Digital-MoBa/Arduino-Z21pg-Zentrale/Aufbau Andreas Schreiber/Bauteilliste/Spannungsregler.jpg

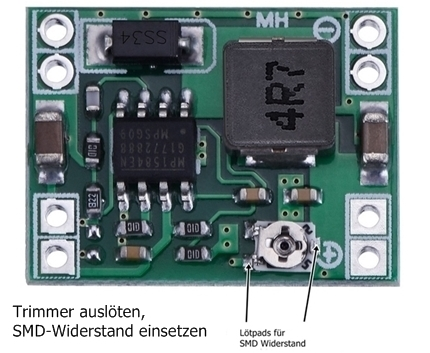
Aufbau Andreas Schreiber/Bauteilliste/Spannungsregler.jpg
