Digital-MoBa/Arduino-Z21pg-Zentrale/Baubericht von Bernd Brendel/Bilder/Hinten.jpg

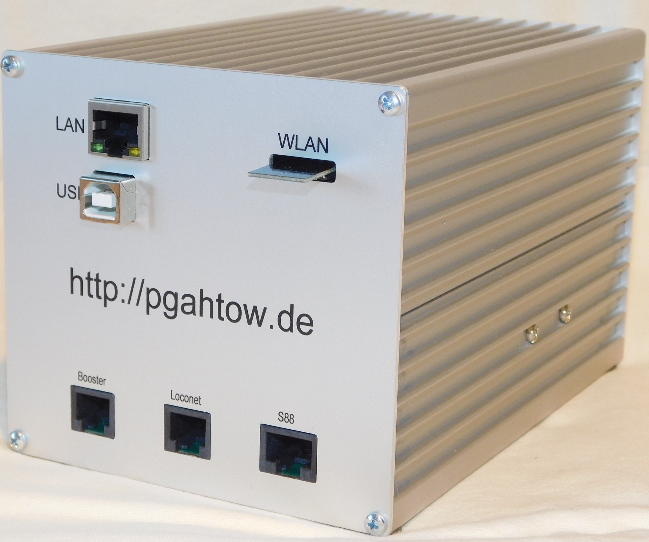
Baubericht von Bernd Brendel/Bilder/Hinten.jpg
