Digital-MoBa/Arduino-Z21pg-Zentrale/Baubericht von Bernd Brendel/Bilder/Innen1.jpg

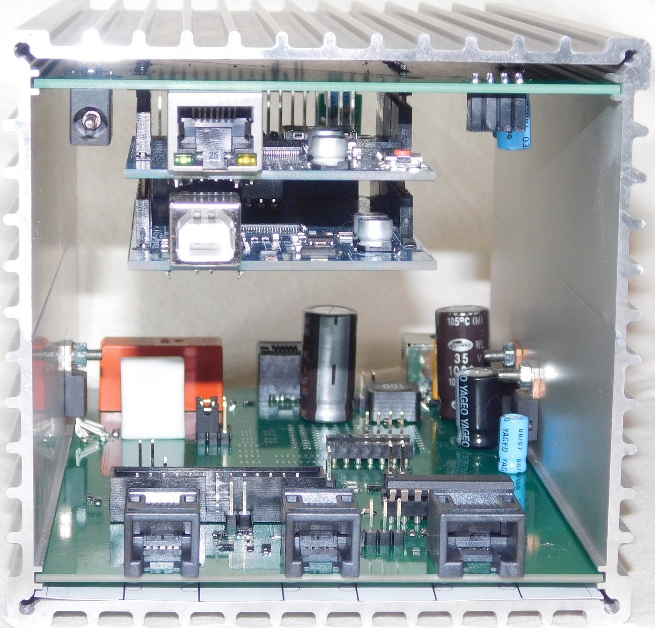
Baubericht von Bernd Brendel/Bilder/Innen1.jpg
