Digital-MoBa/Arduino-Z21pg-Zentrale/Baubericht von Bernd Brendel/Bilder/Vorne.jpg

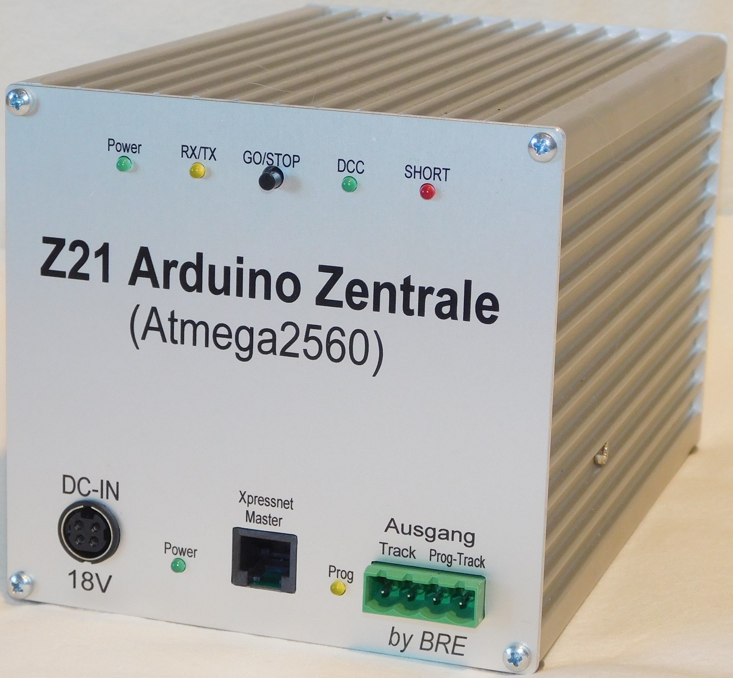
Baubericht von Bernd Brendel/Bilder/Vorne.jpg
