Digital-MoBa/Arduino-Z21pg-Zentrale/Z21pg_DS18B20.jpg

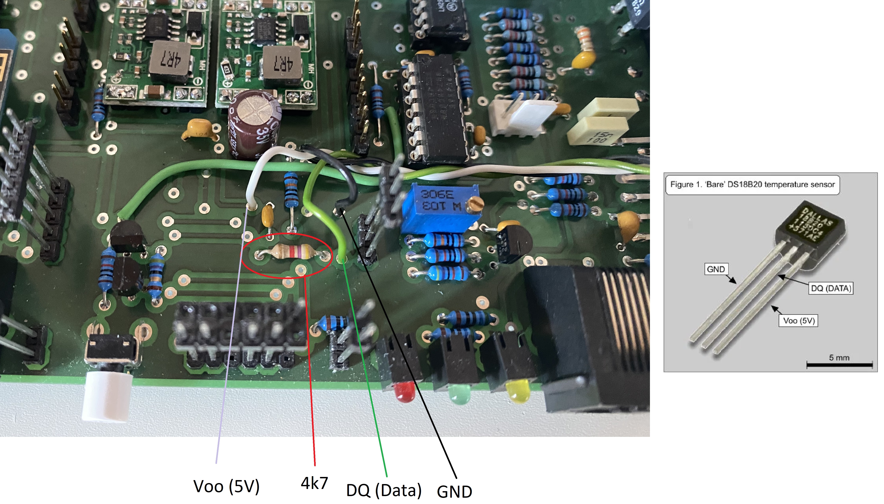
Z21pg_DS18B20.jpg
