Digital-MoBa/Arduino-Z21pg-Zentrale/Aufbau Andreas Schreiber/Bauteilliste/Bauteilliste.xls

Part |  | Reichelt
C1 | 100n | Z5U-5 100N
C2 | 100µF | RAD 100/35
C3 | 100n | Z5U-5 100N
C4 | 100n | Z5U-5 100N
C5 | 1000µF | M-A 1000U 50
C6 | 100n | Z5U-5 100N
C7 | 470n | Z5U-5 470N
C8 | 22n | Z5U-5 22N
C9 | 100n | Z5U-5 100N
C10 | 15nF | MKP2-250 15N
C11 | 15nF | MKP2-250 15N
C12 | 220nF | Z5U-5 220N
C13 | 100nF | Z5U-5 100N
D1 | 1N4004 | 1N 4004
D2 | 1N4148DO35-10 | 1N 4148
D3 | 1N4004 | 1N 4004
DCC_STATUS | LED grün | LED B-3 GN
F1 | PFRA | z.B. PFRA250
IC1 | MAX 485 | MAX 485 CPA
IC3 | LM293 | LM 2903 DIP
IC4 | 74HC244N | SN 74HC244N TEX
IC5 | 74HC08N | SN 74HC08N TEX
IC9 | L6203 | L6203
J1 | Roco Booster | MEBP 6-6S
J2 | S88N | MEBP 8-8S
J3 | LocoNet | MEBP 6-6S
J4 | Xnet | MEBP 6-6S
J8 | Power |  | Holbuchse 5,5/2,1
J9 | Xnet | MEBP 6-6S
JP | 2 Stück | STAPELLEISTE 20
JP | 8 Stück | MPE 087-1-002
JP | 1 Stück | SL 2X17G 2,54
K1 | G2R2 | FIN 40.52.9 12V
OK1 | PC817 | LTV 817
R1 | 2k2 | 1/4W
R2 | 10k | 1/4W
R3 | 10k | 1/4W
R4 | 10k | 1/4W
R5 | 560 | 1/4W
R6 | 560 | 1/4W
R7 | 10k | 1/4W
R8 | 10k | 1/4W
R9 | 10k | 1/4W
R10 | 4,7k | 1/4W
R11 | 0R33/30W | CAD MP930-0.33
R12 | 0R10/30W | CAD MP930-0.10
R13 | 0R10/30W | CAD MP930-0.10
R14 | 100k | 1/4W
R17 | 10k | 1/4W
R20 | 560 | 1/4W
R21 | 100k | 1/4W
R22 | 47k | 1/4W
R23 | 10k | 1/4W
R24 | 4,7k | 1/4W
R25 | 4,7k | 1/4W
R26 | 47 | 1/4W
R27 | 10k | 1/4W 10K
R28 | 47 | 1/4W
R29 | 47 | 1/4W
R30 | 47 | 1/4W
R31 | 47 | 1/4W
R32 | 47 | 1/4W
R33 | 10k | 1/4W
R35 | 15k Temp | NTC-0,2 15K
R36 | 10k | 1/4W
R37 | 120 | 1/4W
R38 | 10k | 1/4W 10K
R39 | 10k | 1/4W
R40 | 1k | 1/4W
R41 | 1k | 1/4W
R42 | 220 | 1/4W
R43 | 220 | 1/4W
R44 | 1M | 1/4W
R45 | 1M | 1/4W
R46 | 220 | 1/4W
R47 | 220 | 1/4W
R48 | 1M | 1/4W
R49 | 1M | 1/4W
R50 | 10k | 1/4W
R51 | 10k | 1/4W
R54 | 3R3 | 1/4W
R55 | 100k | 1/4W
R56 Präzisionspotentiometer | 10k | 64W-10K
S1 |  | TASTER 3305B | (? Kappe)
SEND/RECEIVE | LED gelb | LED B-3 GE
SHORT | LED rot | LED B-3 RT
T1 | BC547 | BC547C
T2 | BC547 | BC547C
T3 | BC547 | BC547C
T4 | BC547 | BC547C
T5 | BC547 | BC547C
T6 | BC547 | BC547C
T8 | BC547 | BC547C
U$2 (Step Down 12V) | MP1584
U$3 (Step Down 5V) | MP1584
X1 1x3-polig - Stecker | 22-23-2031 | MOLEX 26604030 | (für Anschluss Lüfter)
X2 Wannenstecker | PROG | AKL 230-02 & | AKL 249-02
X5 Wannenstecker | Gleis | AKL 230-03 & | AKL 249-03
Kühlkörper | 1 Stück | SK 68/100
5V (Spannungsregler) | 1 Stück | SMD 1/4W 43K
12V (Spannungsregler) | 1 Stück | SMD 1/4W 110K
Distanzhülsen | 4 Stück | DA 8MM
Distanzhülsen | 2 Stück | DA 10MM
Mutter M3 | 2 Stück | (SK-E M3-100)
PC Schrauben | 2 Stück | (ST SCREWM3)
Präzision-Sockelstreifen | 2 Stück | MPE 006-1-002
IC-Sockel, 20-polig | 1 Stück | GS 20P
IC-Sockel, 14-polig | 1 Stück | GS 14P
IC-Sockel, 8-polig | 2 Stück | GS 8P
Glimmerscheibe | 1 Stück | GLIMMER TO 218
Isolierbuchse | 1 Stück | IB 8
Wärmeleitpaste | 1 Stück | NO NT-H1
Schrauben (Kühlkörper L6203 & …) | 2 Stück |  | ? PT- oder TP-Schrauben
(? Lüfter) |  |  | Noctua NF-A4x20 FLX, 12V, 3-Pin
Mega2560 R3 Mikrocontroller | 1 Stück
Ethernet Shield W5100 | 1 Stück
D1 Mini NodeMcu | 1 Stück
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
