Digital-MoBa/Arduino-Z21pg-Zentrale/Aufbau Andreas Schreiber/Bauteilliste/Bestücken.pdf

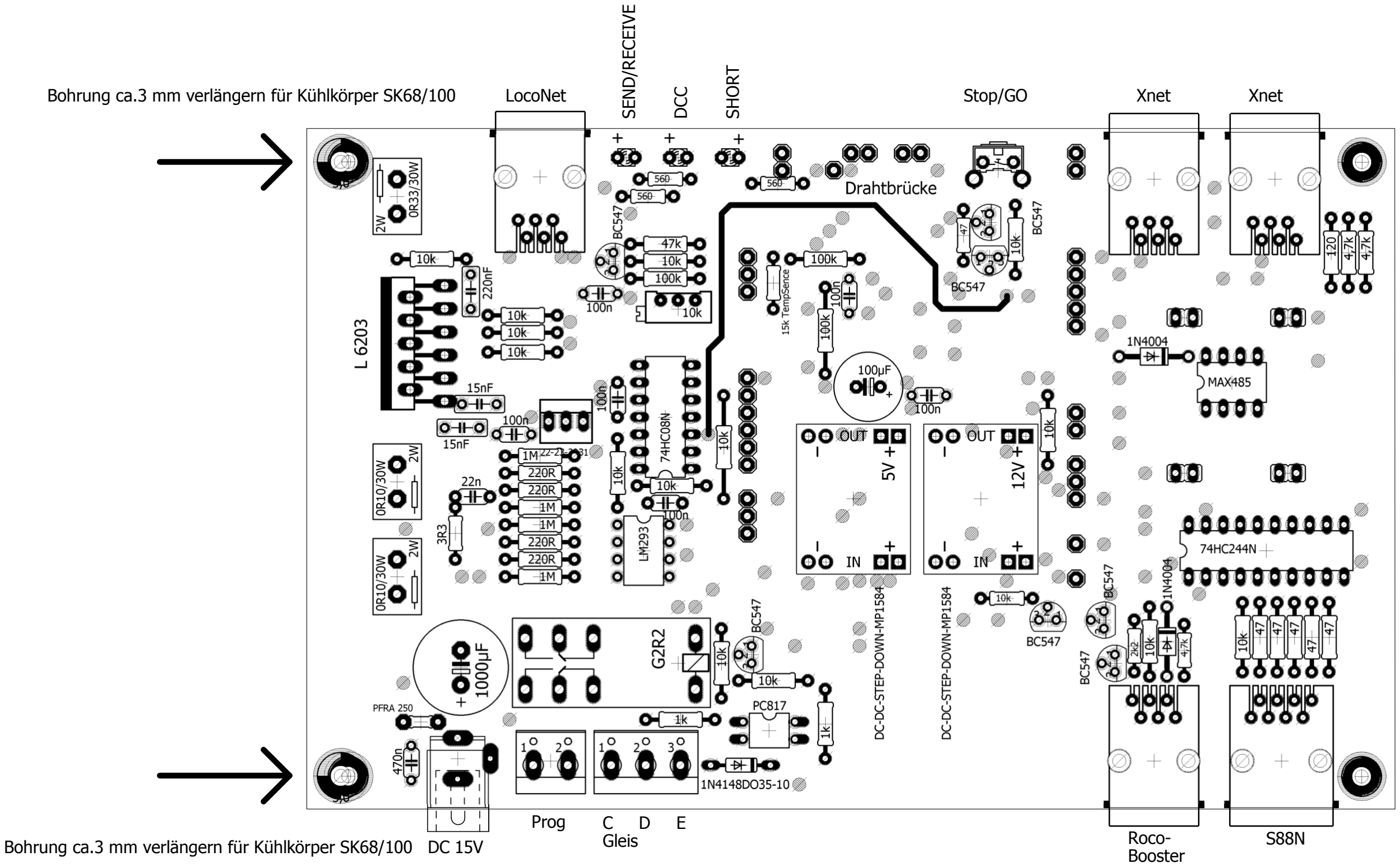
[picture p9: page 1]

+ | +
LocoNet | Xnet | Xnet

Roco-
Booster | S88N DC 15V
Prog | C | D | E
| Gleis

Stop/GO

SEND/RECEIVE

DCC

SHORT Bohrung ca.3 mm verlängern für Kühlkörper SK68/100

Bohrung ca.3 mm verlängern für Kühlkörper SK68/100
