Digital-MoBa/Arduino-Z21pg-Zentrale/Aufbau Andreas Schreiber/Bilder/IMG_1150.JPG

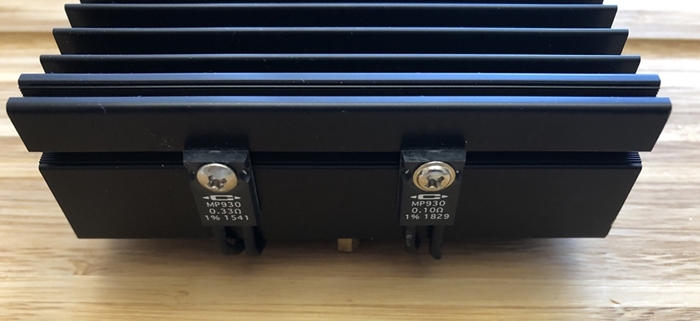
Aufbau Andreas Schreiber/Bilder/IMG_1150.JPG
