Digital-MoBa/Arduino-Z21pg-Zentrale/Aufbau Andreas Schreiber/Bilder/IMG_1151.JPG

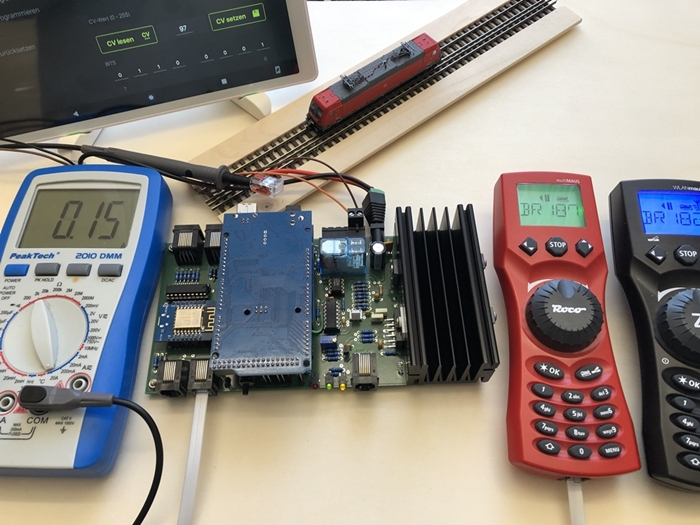
Aufbau Andreas Schreiber/Bilder/IMG_1151.JPG
