Digital-MoBa/Arduino-Z21pg-Zentrale/Aufbau Andreas Schreiber/Gerber.jpg

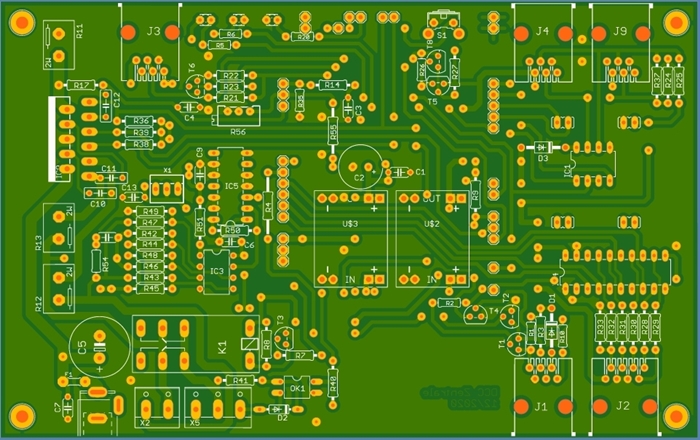
Aufbau Andreas Schreiber/Gerber.jpg
