Digital-MoBa/Arduino-Z21pg-Zentrale/Baubericht von Bernd Brendel/Baubericht.pdf

Hallo liebe Bastelfreunde und Modellbahner,

ich habe mich im Sommer 2020 entschieden, die Z21-Zentrale mit dem ATmega 2560 von Philipp nachzubauen:

http://pgahtow.de/wiki/index.php?title=Z21_Arduino_Zentrale_(Atmega2560)

Bitte habt Verständnis, dass ich keine Garantie geben kann, falls doch noch was nicht richtig funktioniert. Ich habe den Aufbau an meinen Bedarf angepasst.

Die Elektronik habe ich auf zwei Leiterplatten verteilt, welche ich nacheinander bei MME-PCB (http://www.mme-pcb.com/) fertigen ließ. Diese sind günstig, aber haben lange Lieferzeiten, 2 Monate sind keine Seltenheit. Beide Leiterplatten wurden mit Eagle 6.5 entworfen, da ich beruflich Zugang zur Vollversion habe und in meinen Pausen / am Wochenende auch privates machen darf .

Der Hardwarestand von Philipp ist Sommer 2020, der Sketch V4.86 läuft drauf. Der Anschluss eines LocoNet-Boosters ist noch nicht vorhanden (LocoNet-B - Buchse)

Es sollte der Treiber TLE5206-2 verwendet werden.
Der TLE5205-2 hat eine andere Ansteuerung!

Als Gehäuse habe ich ein Euro-Kühlrippengehäuse (Proma 130 048) von Völkner/Conrad gewählt. Dementsprechend sind die Leiterplatten jeweils 165x100mm groß.
Frontplatte und Rückwand habe ich mit Target 3001! (PCB-Pool Edition, kostenlos) erstellt und bei PCB-Pool geordert. Bei den rechteckigen Ausbrüchen müssen noch die Ecken nachgearbeitet werden, da sie gefräst wurden und einen kleinen Radius haben. Das Aluminium hat eine Dicke von 1,5 mm, die Schrift ist aufgedruckt.

Bei den Bauteilen habe ich versucht, meine Vorhandenen zu verwenden, wie z.B. Transistoren und UART-Pegelwandler. Als Transistoren benutze ich Transistoren mit integrierten Widerständen (PDTC143ZT), (https://www.reichelt.de/npn-silicon-digital-transistors-50v-100ma-0-25w-sot-23-pdtc-143zt-nxp-p219246.html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) so genannte Digital-Transistoren oder auch Pre-Biased Transistoren genannt. Das Erspart mir Platz auf meinen Leiterplatten und Lötarbeit. Der Pegelwandler für die UART zum WLAN-Modul ist in jeder Richtung ein 74LVC1T45. Dieser eignet sich sehr gut zum Wandeln von 5V nach 3,3V und umgekehrt. Pin5 bestimmt dabei die Datenrichtung.

Der Arduino mit dem LAN-Shield 'hängt' an der Decke. Die Carrier-LP beinhaltet einen DC/DC-Wandler 12V5V um die Verlustleistung zu reduzieren, einen UART -Pegelwandler zum ESP8266, Status-LEDs, Stop/GO - Taster und einen Stecker für ein Flachbandkabel zur unteren LP.
Am Arduino Mega habe ich die DC-Eingangsbuchse (mittels Heißluft) entfernt: Der kleine Längs-Spannungsregler wird sehr heiß, wenn vom Arduino auch noch das LAN-Shield versorgt wird.
Die Stiftleisten sind zum Teil etwas höher eingelötet, damit alles gerade ist und Kontakt hat.
Seite 1 von 13 | 03/2021

Die untere LP beinhaltet den kompletten Power-Bereich, den Stecker für das Flachbandkabel, sowie alles rund um die Western-Buchsen. Spannungsregler und die Endstufe wurden am Gehäuse festgeschraubt, um Wärme abzuführen. Dabei muß die Endstufe auf jeden Fall isoliert werden. Das Gehäuse liegt am - Pol der Stromversorgung/ auf Masse, also vorsichtig mit anderen Spannungsführenden Teilen der Modellbahn. Bei einem PC mit USB-Verbindung wird das Gehäuse auf Schutzleiter-Potential gezogen durch die Abschirmung.

In den Bildern ist zu sehen, dass ich ein paar 'Angst-Bauteile' vorgesehen habe, um weitere Bauteile für Änderungen bestücken zu können. Diese habe ich für den Bericht entfernt, da die Funktion der Zentrale nun meinen Ansprüchen genügt.

Die Zentrale wird mit 16..20V= versorgt, je nach Spurweite und Bedarf.
Die Ausgangsspannung liegt ca. 1V unter der Eingangsspannung. Es kann z.B. das Netzteil Meanwell GST120A20-R7B (https://www.reichelt.de/tischnetzteil-120-w-20-v-6-a-mw-gst120a20-p171065.html?&trstct=pos_0&nbc=1) (20V/6A) für größere Spurweiten verwendet werden.

Eine ROCO-Lokmaus und ein ROCO-Booster funktionieren, sowie die Ansteuerung über LAN mit der Z21-App. Da am ROCO-Booster 12V rauskommen, habe ich die Verbindung zu den 12V in der Zentrale getrennt, damit keine gegenseitige Speisung erfolgen kann. Das WLAN - Modul funktioniert nach einer kleinen Schaltungskorrektur nun auch.
In dieser Doku ist schon die überarbeitete Variante von Schematic und Board.

Auf Grund fehlender Hardware konnte ich folgendes noch nicht testen:
S88 - Anschluss und LocoNet.
Seite 2 von 13 | 03/2021

Komplettes Gerät:

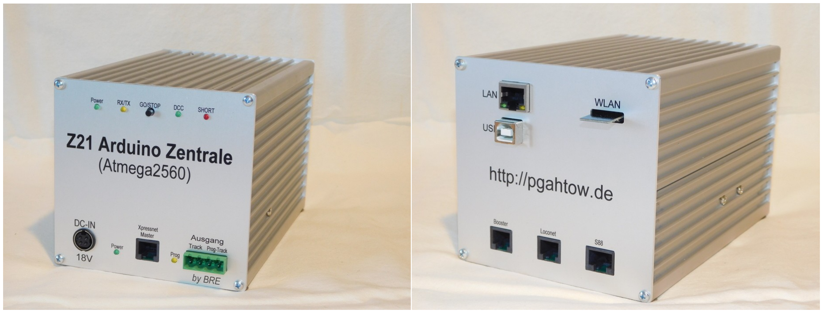
[picture p15: figure]

Das WLAN-Modul ragt heraus.

Seite 3 von 13 | 03/2021

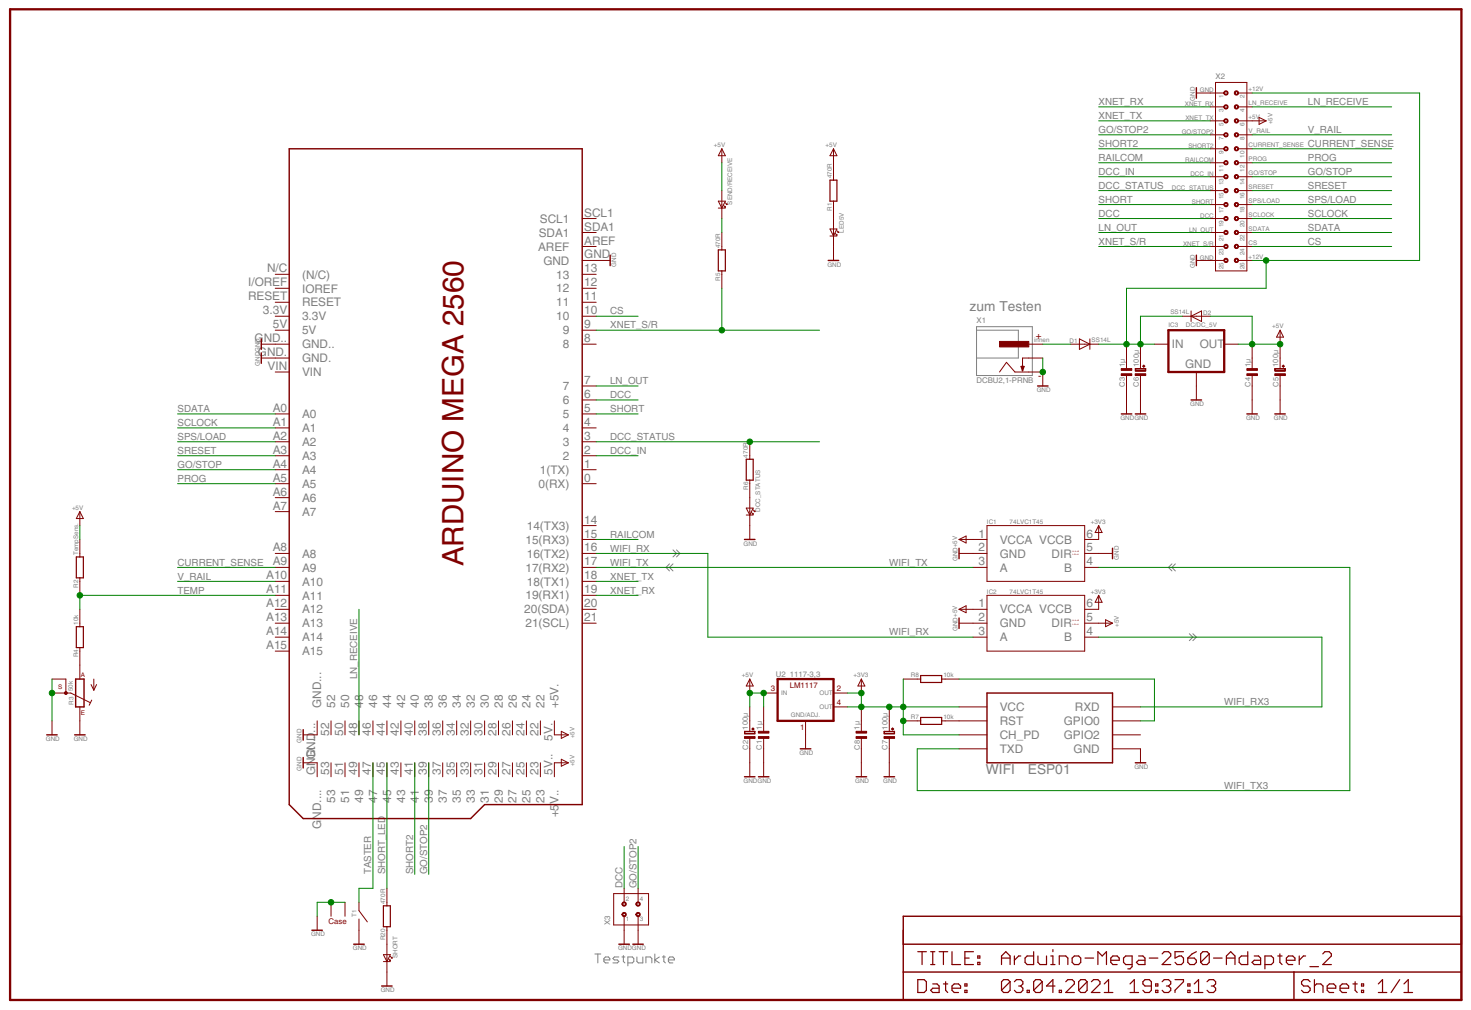
[picture p16: page 4]
zum Testeninnen; GND GND GND GND; GND GND; GND; 1117-3,3 GND; GND 10k 10k 100µ 1µ GND; 74LVC1T45 74LVC1T45 GND GND ⁺⁵V +5V; +3V3 +3V3 +3V3 1µ100µ GNDGND ⁴⁷⁰R; GND GND GND; +5V470R GND; DC/DC_5V GND; +5V 1µ GND; 1µ GND DCBU2,1-PRNB; SS14L GND GNDGND TempSens. 50k GND +5V GND; 100µ GND ¹⁰⁰µ GND GND +5V; 19 20(SDA); 20 21(SCL); AREF; AREF GND; GND GND. GND.; GND.. GND..; GND... GND... GND.... GND.... IOREF I/OREF; RESET RESET; SCL1; SCL1 SDA1; SDA1 VIN VIN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

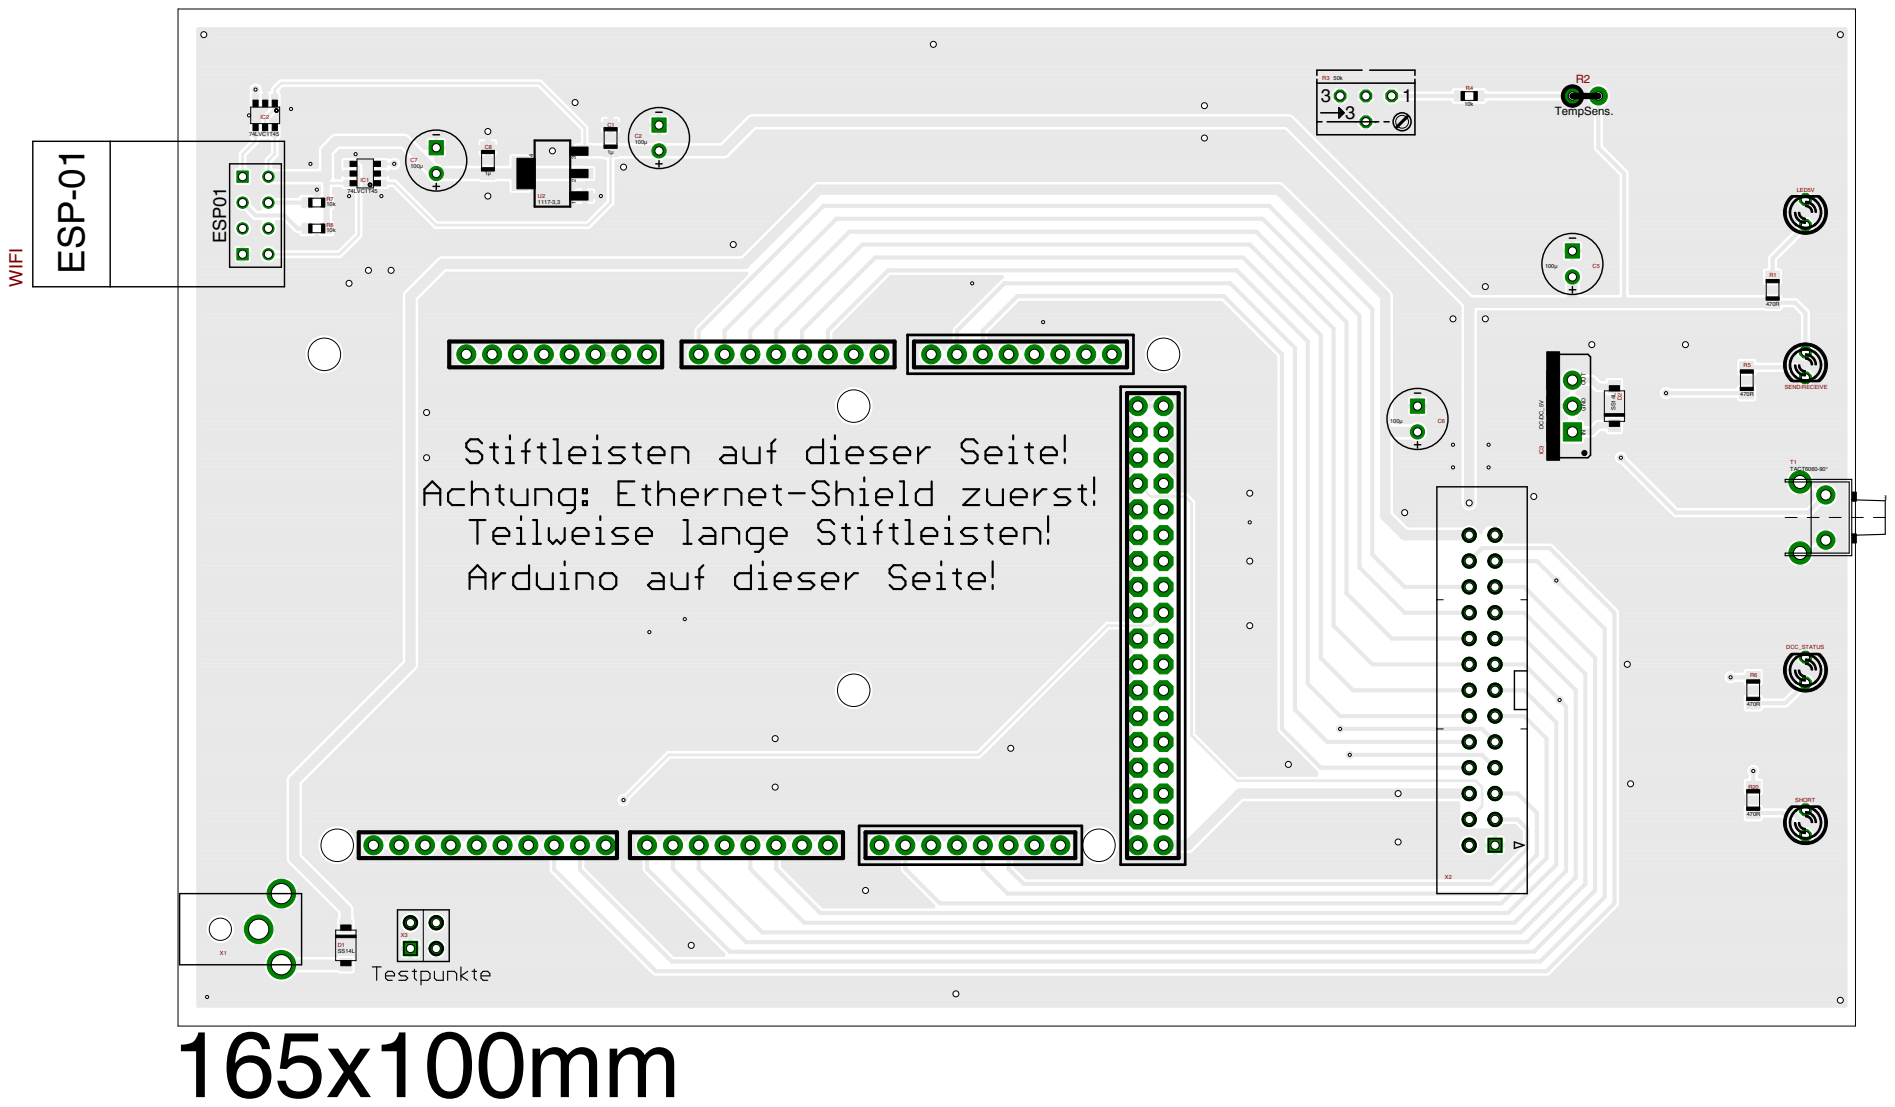
[picture p17: page 5]

43 1 2 ESP-01 GND IN OUT 3 1 165x100mm 3,5mm 3 X2 U2 R7R8 C7 C8 IC1 IC2 C1 C2 WIFI SEND/RECEIVE DCC_STATUS SHORT R5R6 R20 T1 R1 LED5V IC3 X1 D1 X3 R2 R3 R4 C5 C6 D2 1117-3,3 10k 10k 100µ 1µ 74LVC1T45 74LVC1T45 1µ 100µ ESP01 470R470R 470R TACT6060-90° 470R DC/DC_5V SS14L TempSens. 50k 10k 100µ 100µ SS14L

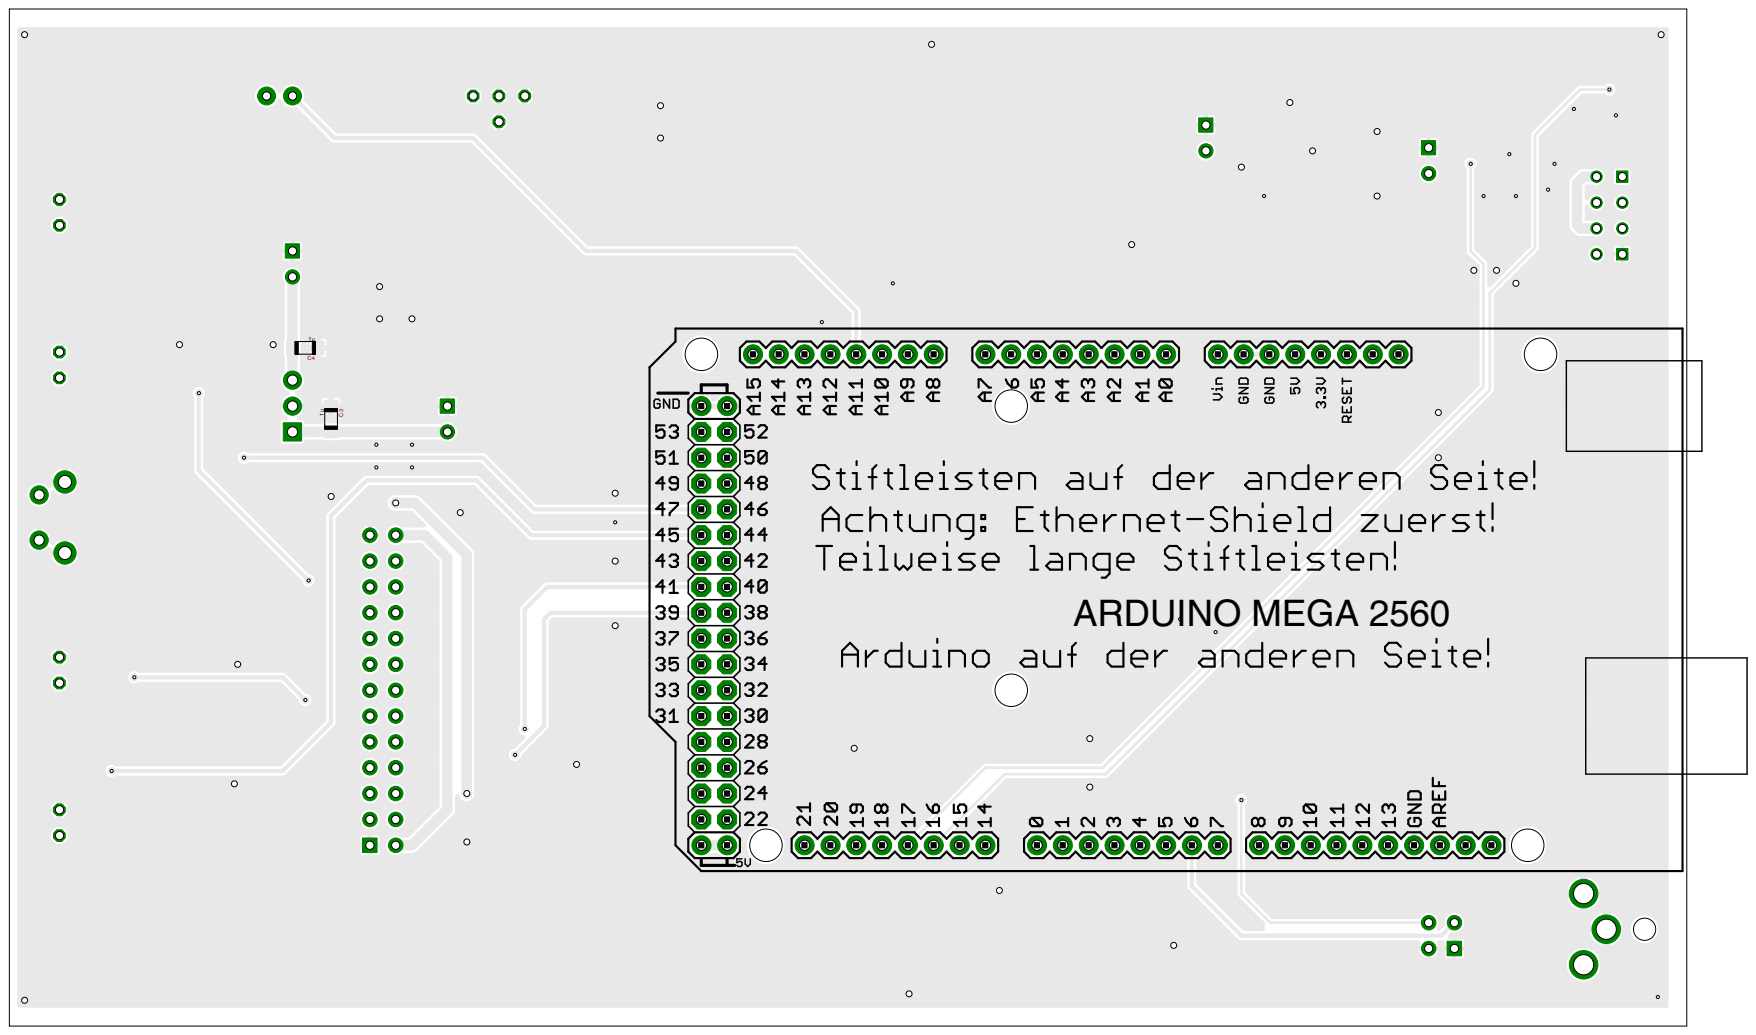
[picture p18: page 6]
ARDUINO MEGA 2560

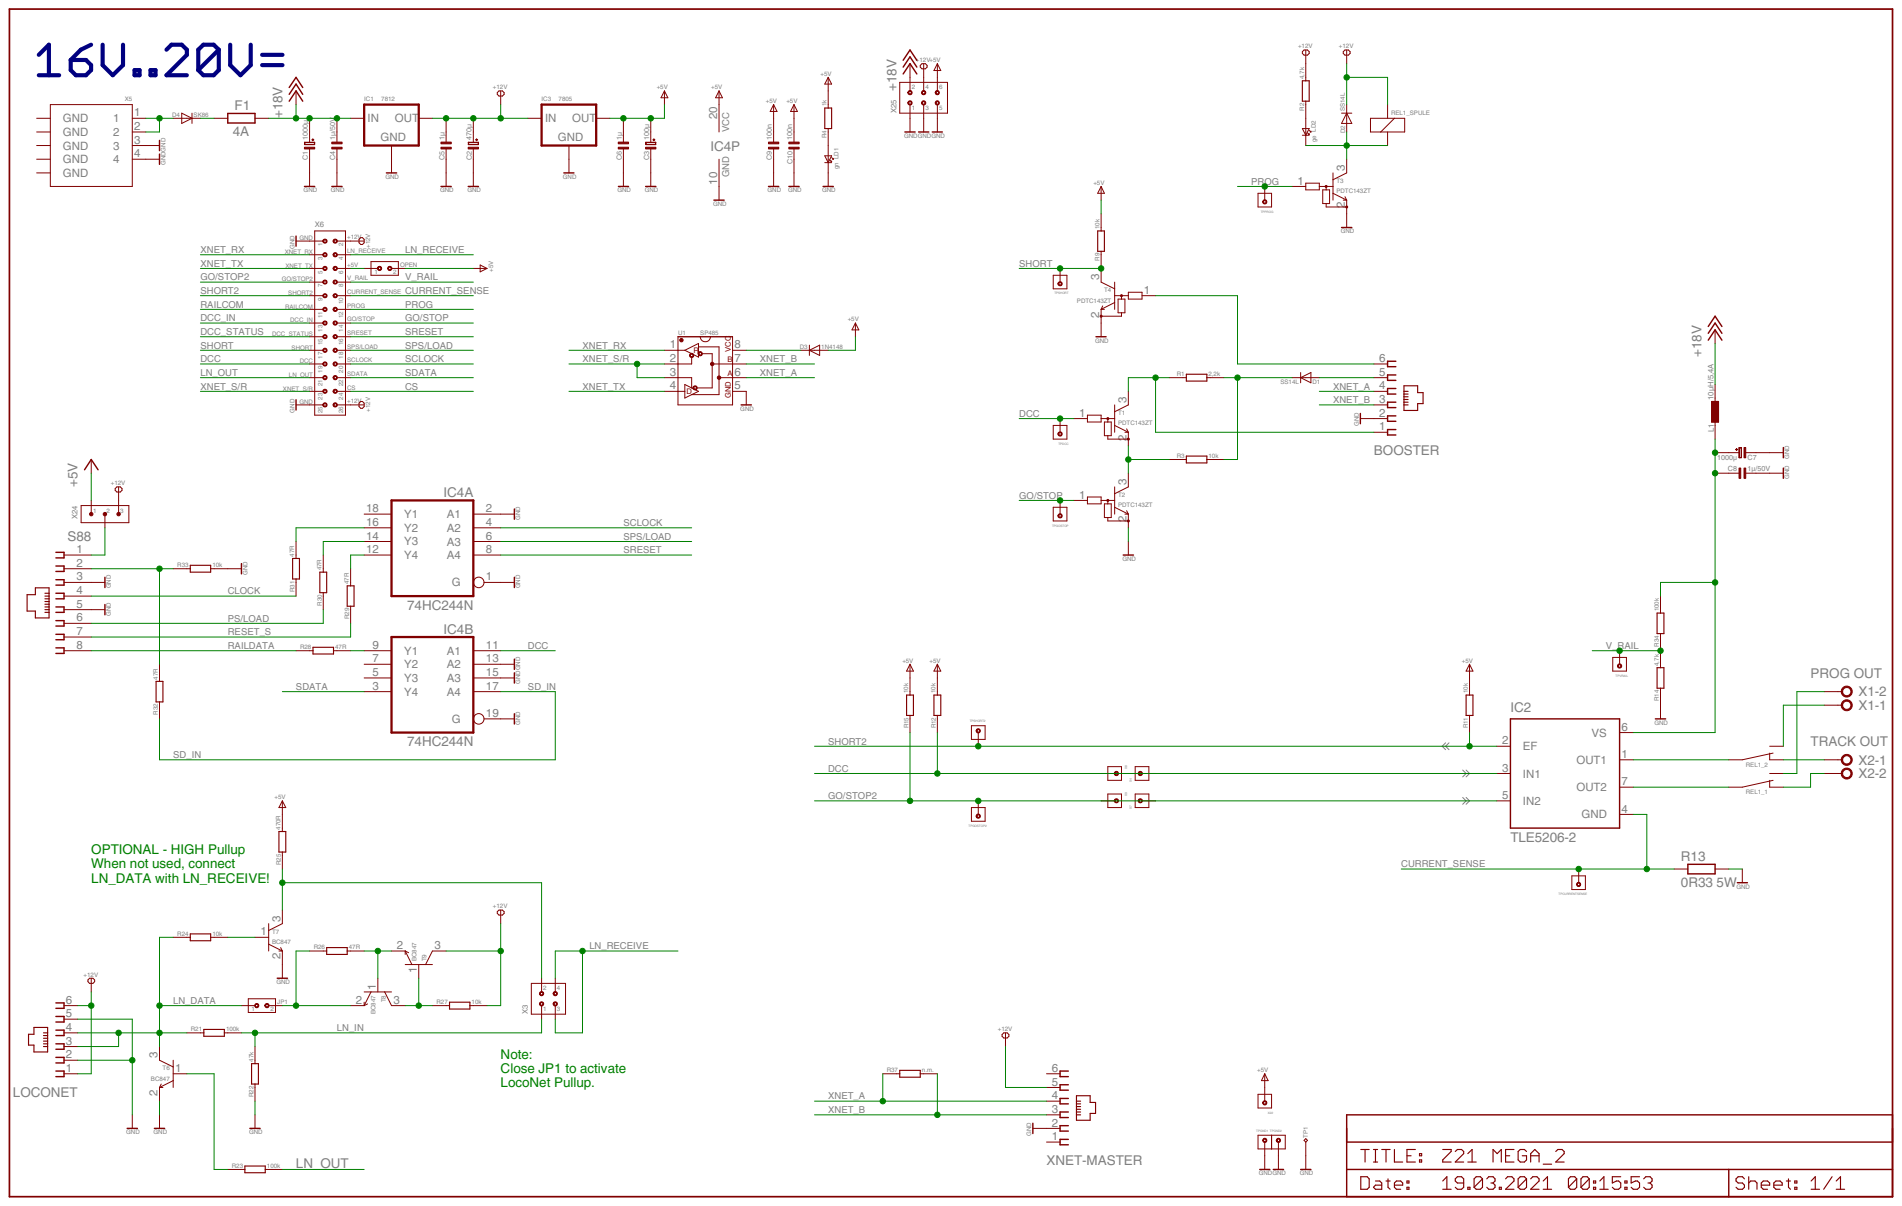
[picture p19: page 7]

4 GND GND GND GND GND

SPS/LOAD GO/STOP

OPTIONAL - HIGH Pullup When not used, connect LN_DATA with LN_RECEIVE!

Note: Close JP1 to activate

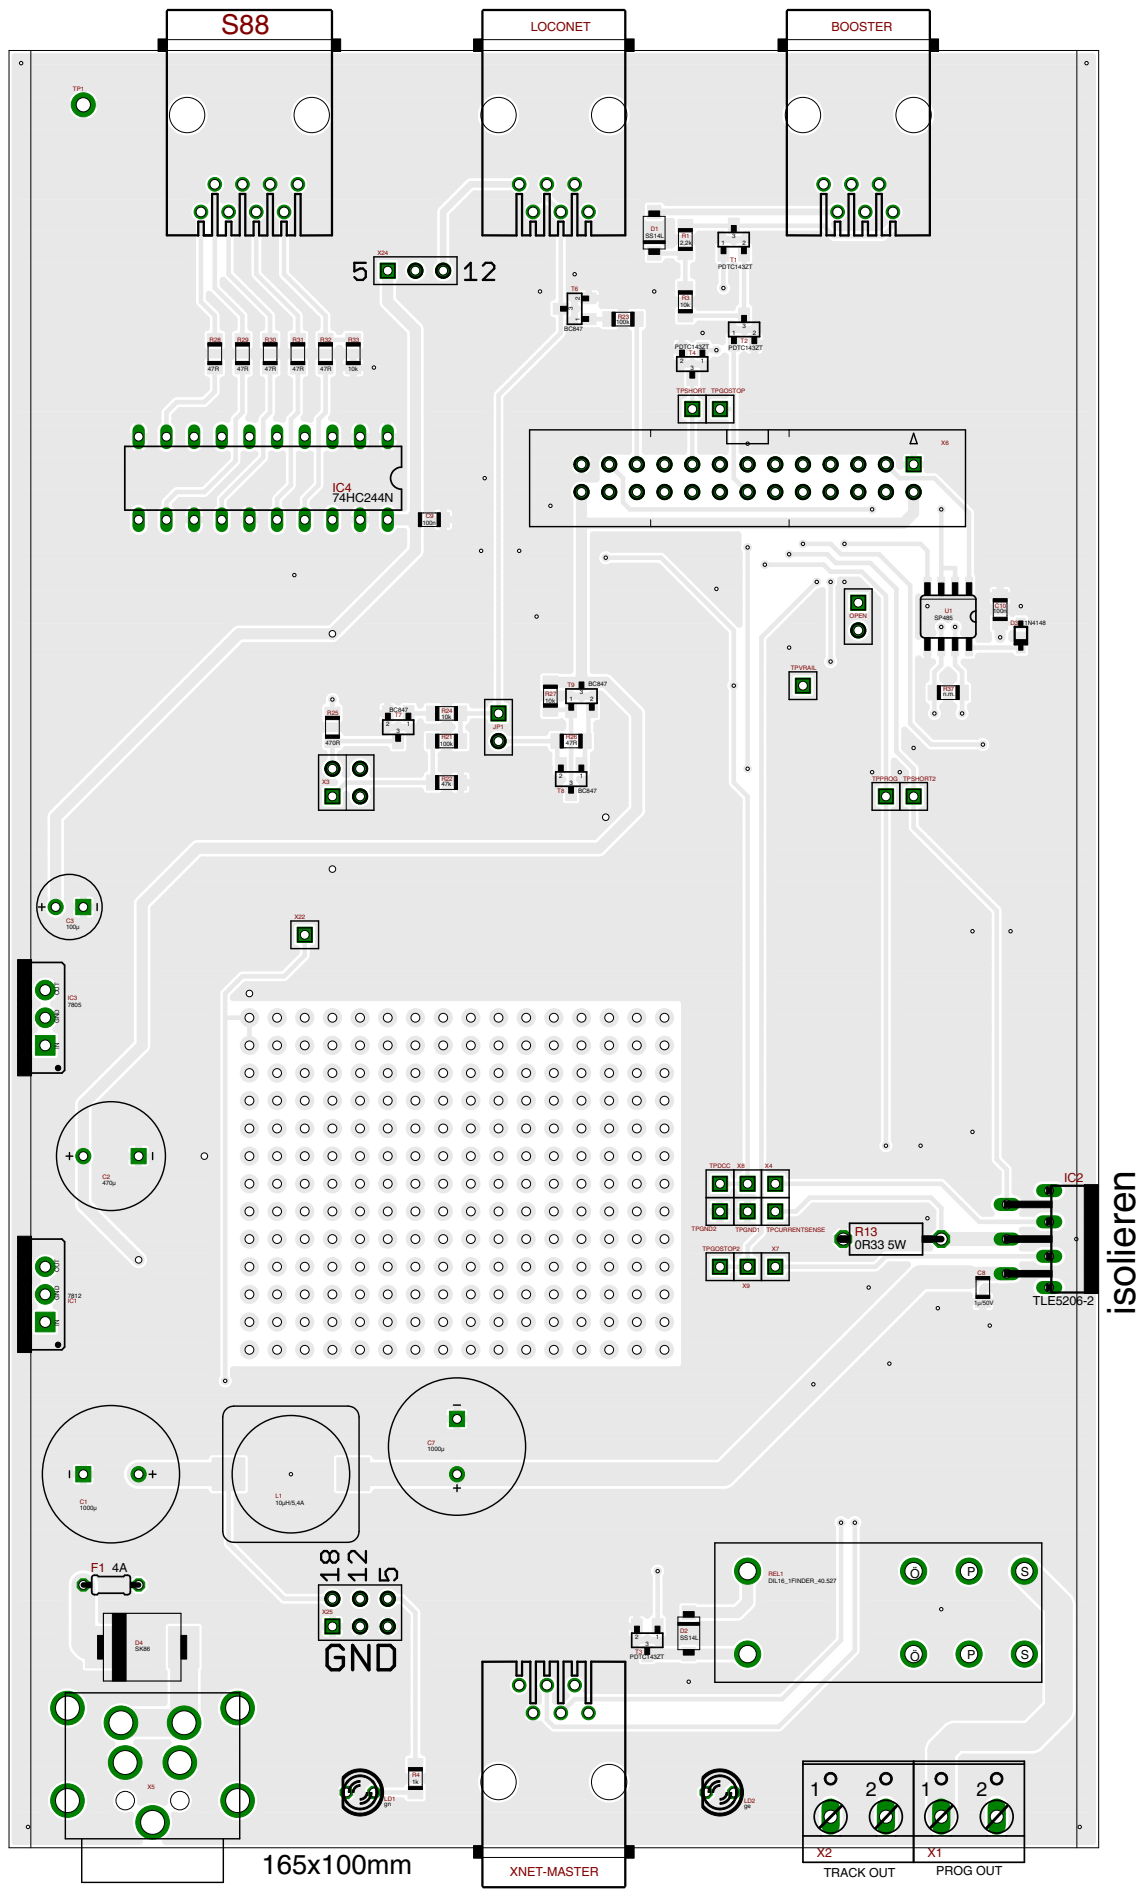
[picture p20: page 8]

GND IN OUT

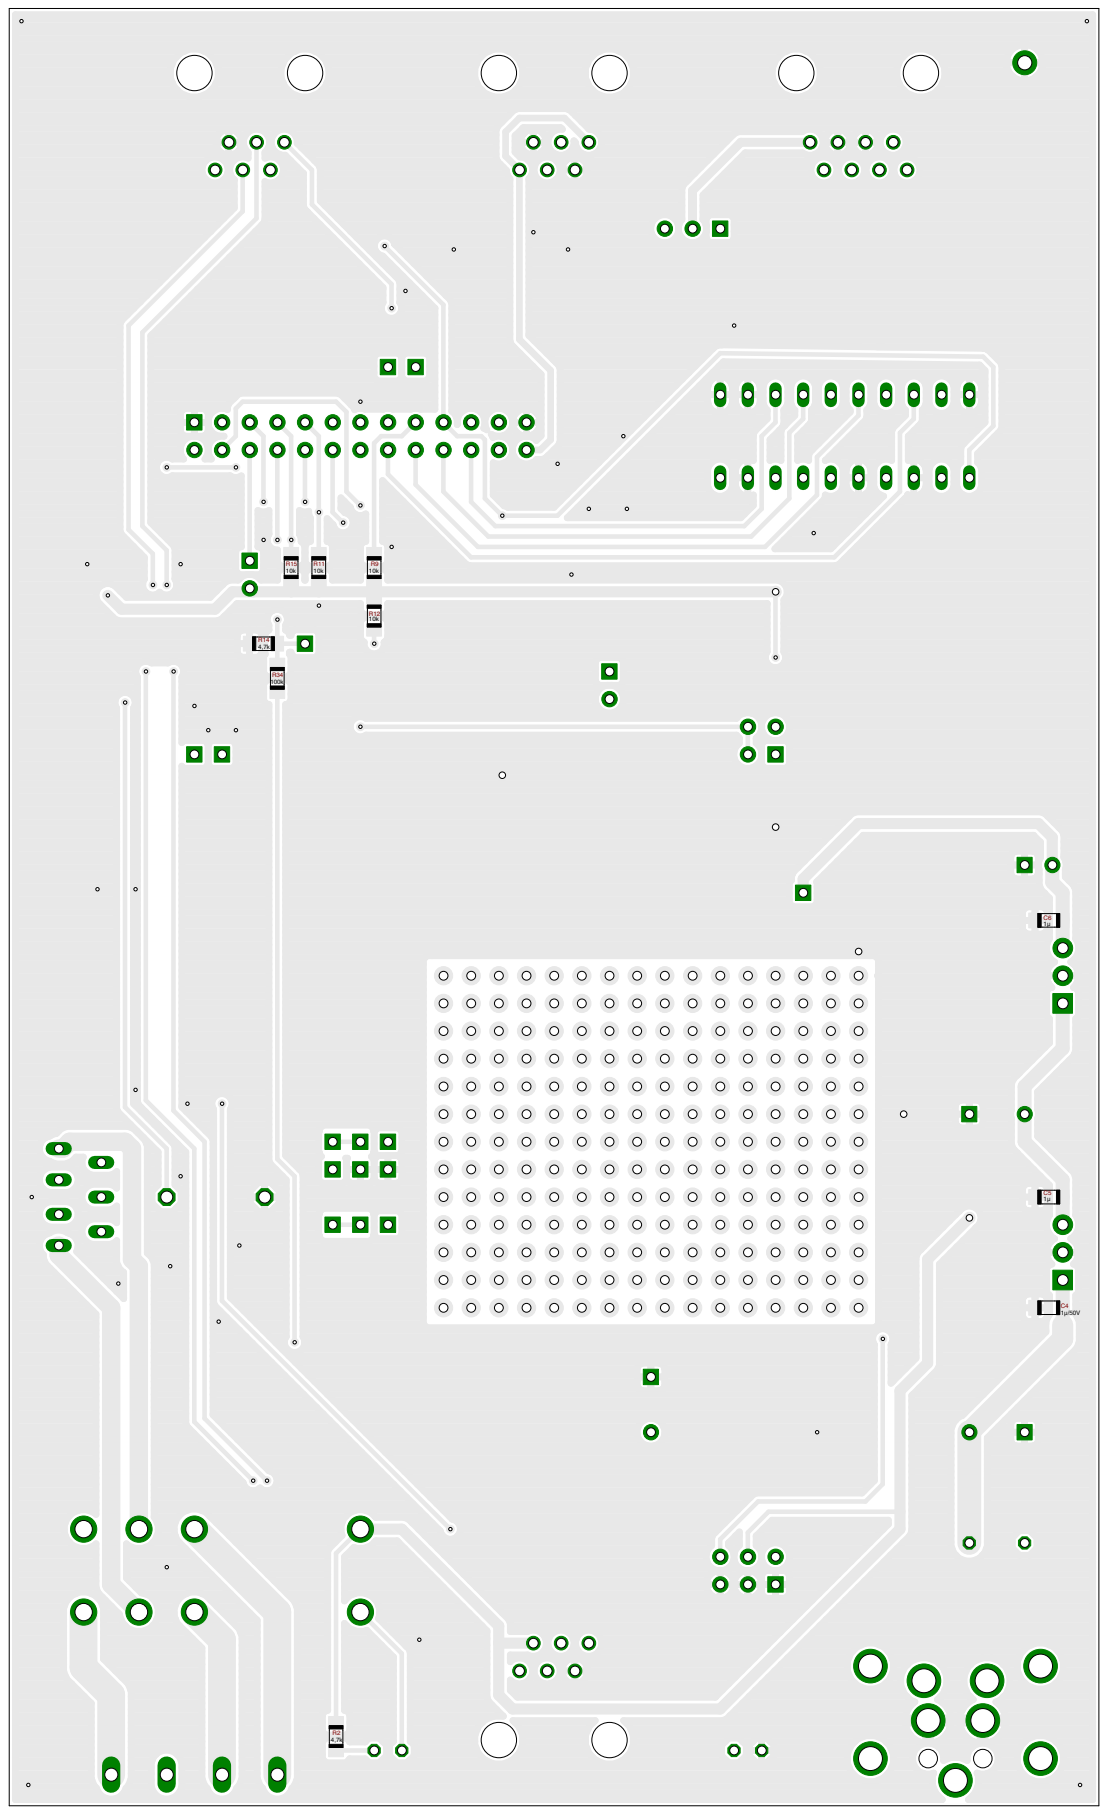
[picture p21: page 9]

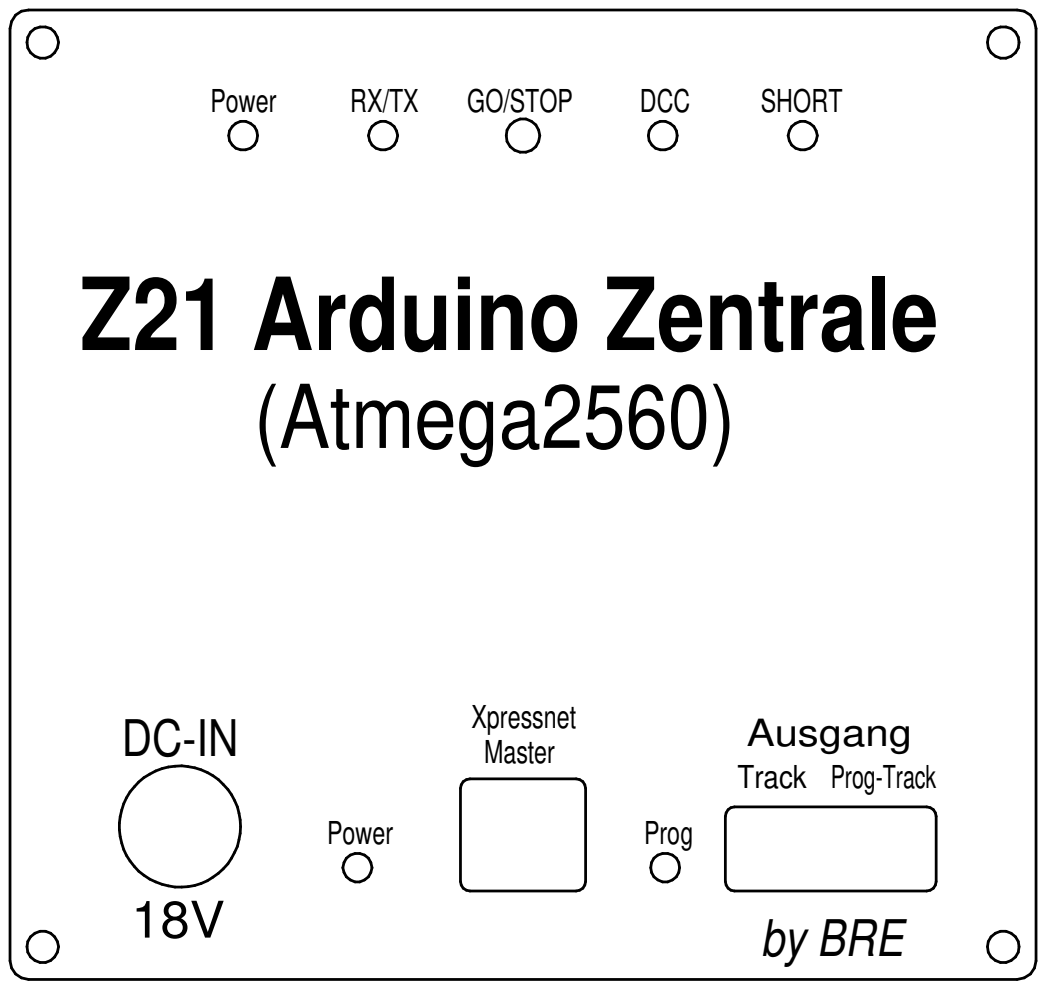
[picture p22: page 10]
Z21 Arduino Zentrale (Atmega2560); Power; GO/STOP; DCC; SHORT; Prog; Master; Prog-Track; Track; Xpressnet; Ausgang; by BRE

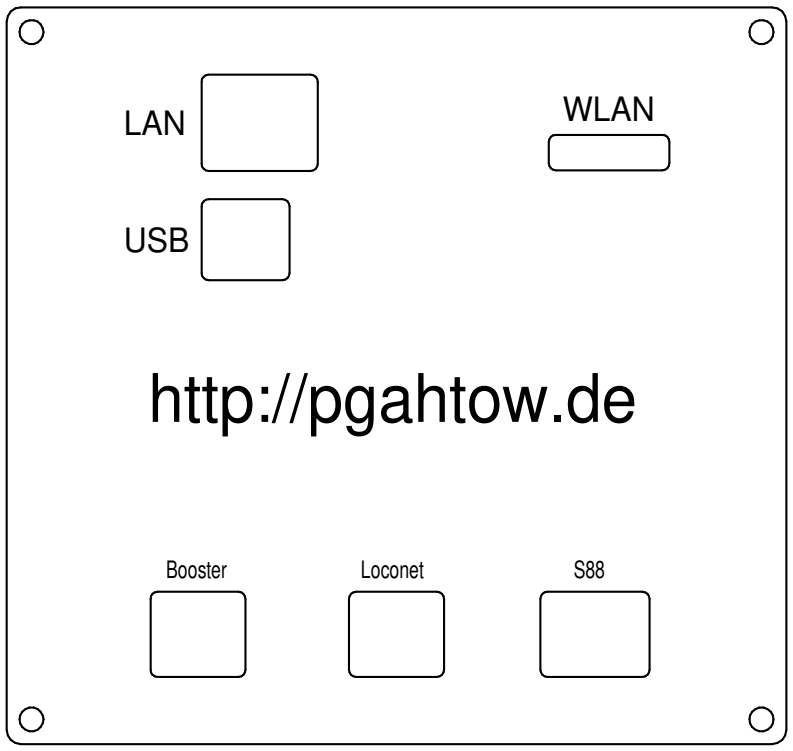
[picture p23: figure]
http://pgahtow.de; WLAN; USB; LAN; Booster; Loconet
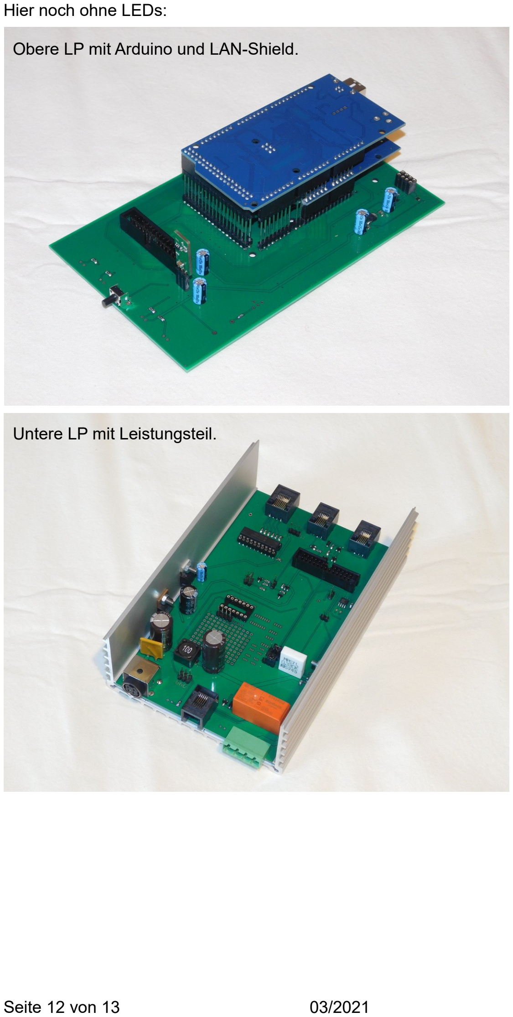
[picture p24: page 12]

Hier noch ohne LEDs:

Obere LP mit Arduino und LAN-Shield.

Untere LP mit Leistungsteil.

Seite 12 von 13 | 03/2021

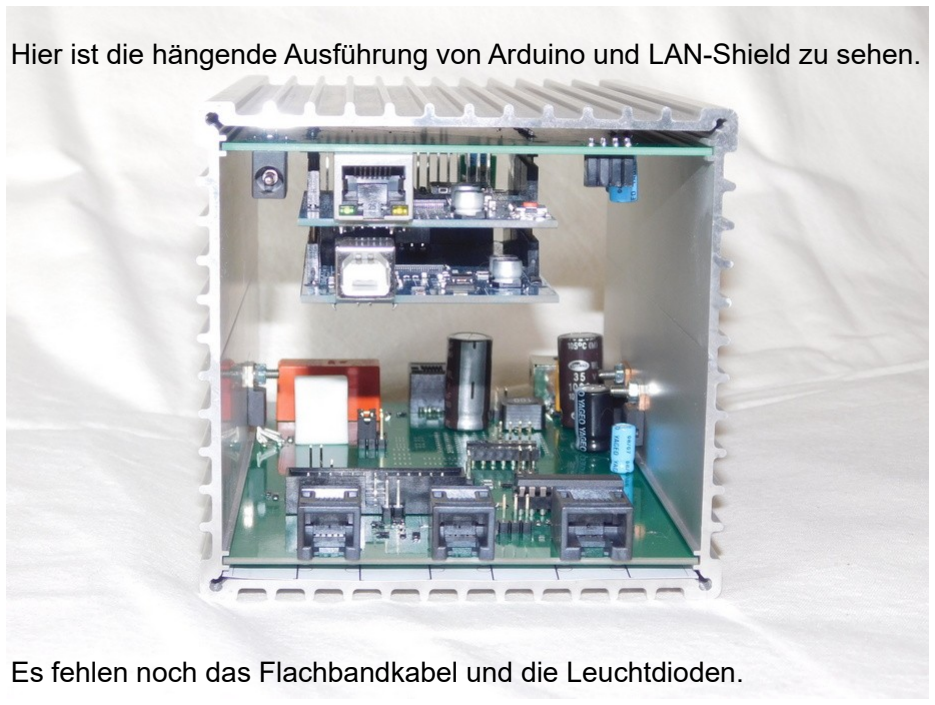
[picture p25: figure]

Hier ist die hängende Ausführung von Arduino und LAN-Shield zu sehen.

Es fehlen noch das Flachbandkabel und die Leuchtdioden.

Bei den bedrahteten Bauteilen ist darauf zu achten, dass die Beine kurz abgeschnitten werden, damit kein Kontakt zum Gehäuse entsteht. Gegebenfalls das Gehäuse mit Klebeband isolieren oder ein dickes Stück Papier bzw. dünne Pappe zwischen Gehäuse und Leiterplatte.

Meine Bezugsquellen für Bauteile:
- Völkner (http://www.voelkner.de/) / Conrad (http://www.conrad.de/)
- Reichelt (http://www.reichelt.de/)
- Segor (http://www.segor.de/) in Berlin, auch Versand
- Mouser (http://www.mouser.de/)

Bei Fehlern und Anregungen könnt Ihr mich kontaktieren.

Nochmal vielen Dank an Philipp für die Idee und Entwicklung der Zentrale.

Grüße aus Berlin
Bernd ( b.brendel@gmx.de )
Seite 13 von 13 | 03/2021
