Digital-MoBa/Arduino-Z21pg-Zentrale/Aufbau Andreas Schreiber/Bauteilliste/Schaltplan.pdf

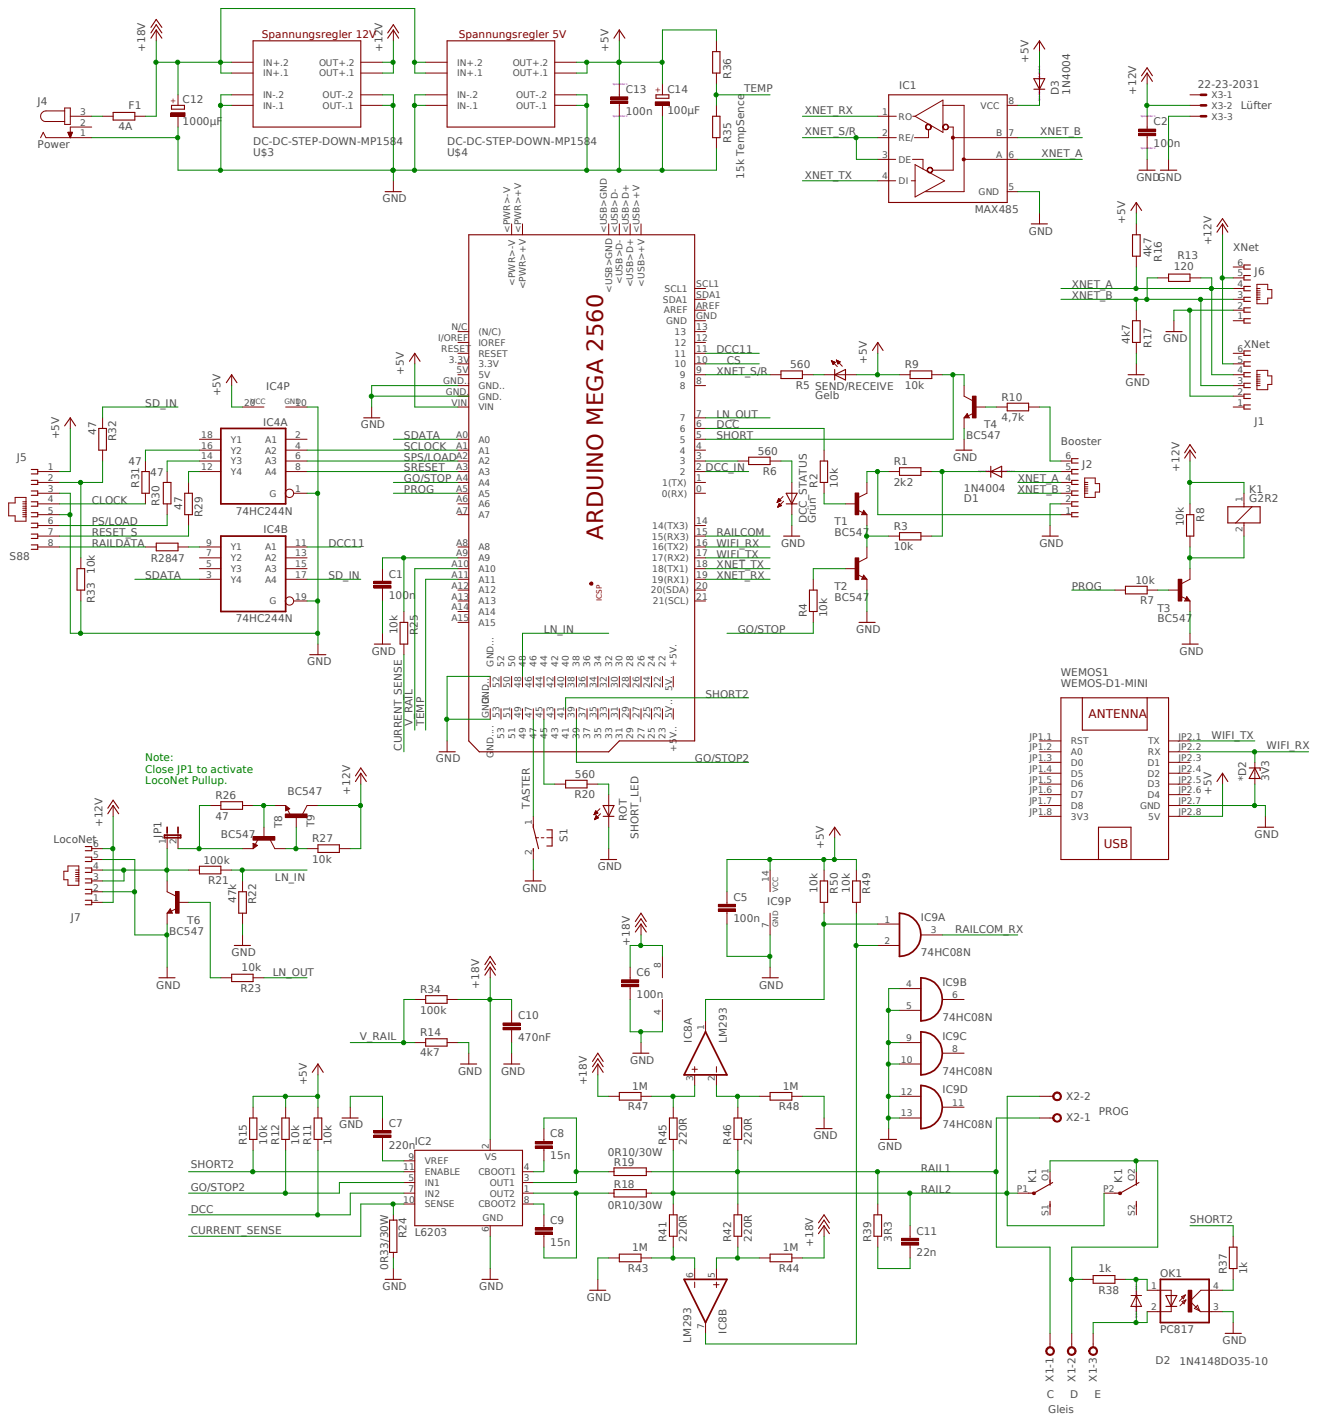
[picture p26: page 1]

GND. | 7
VIN

10 | 8
