Digital-MoBa/Arduino-Z21pg-Zentrale/Aufbau Andreas Schreiber/Bauteilliste/Schaltpl_Platine.pdf

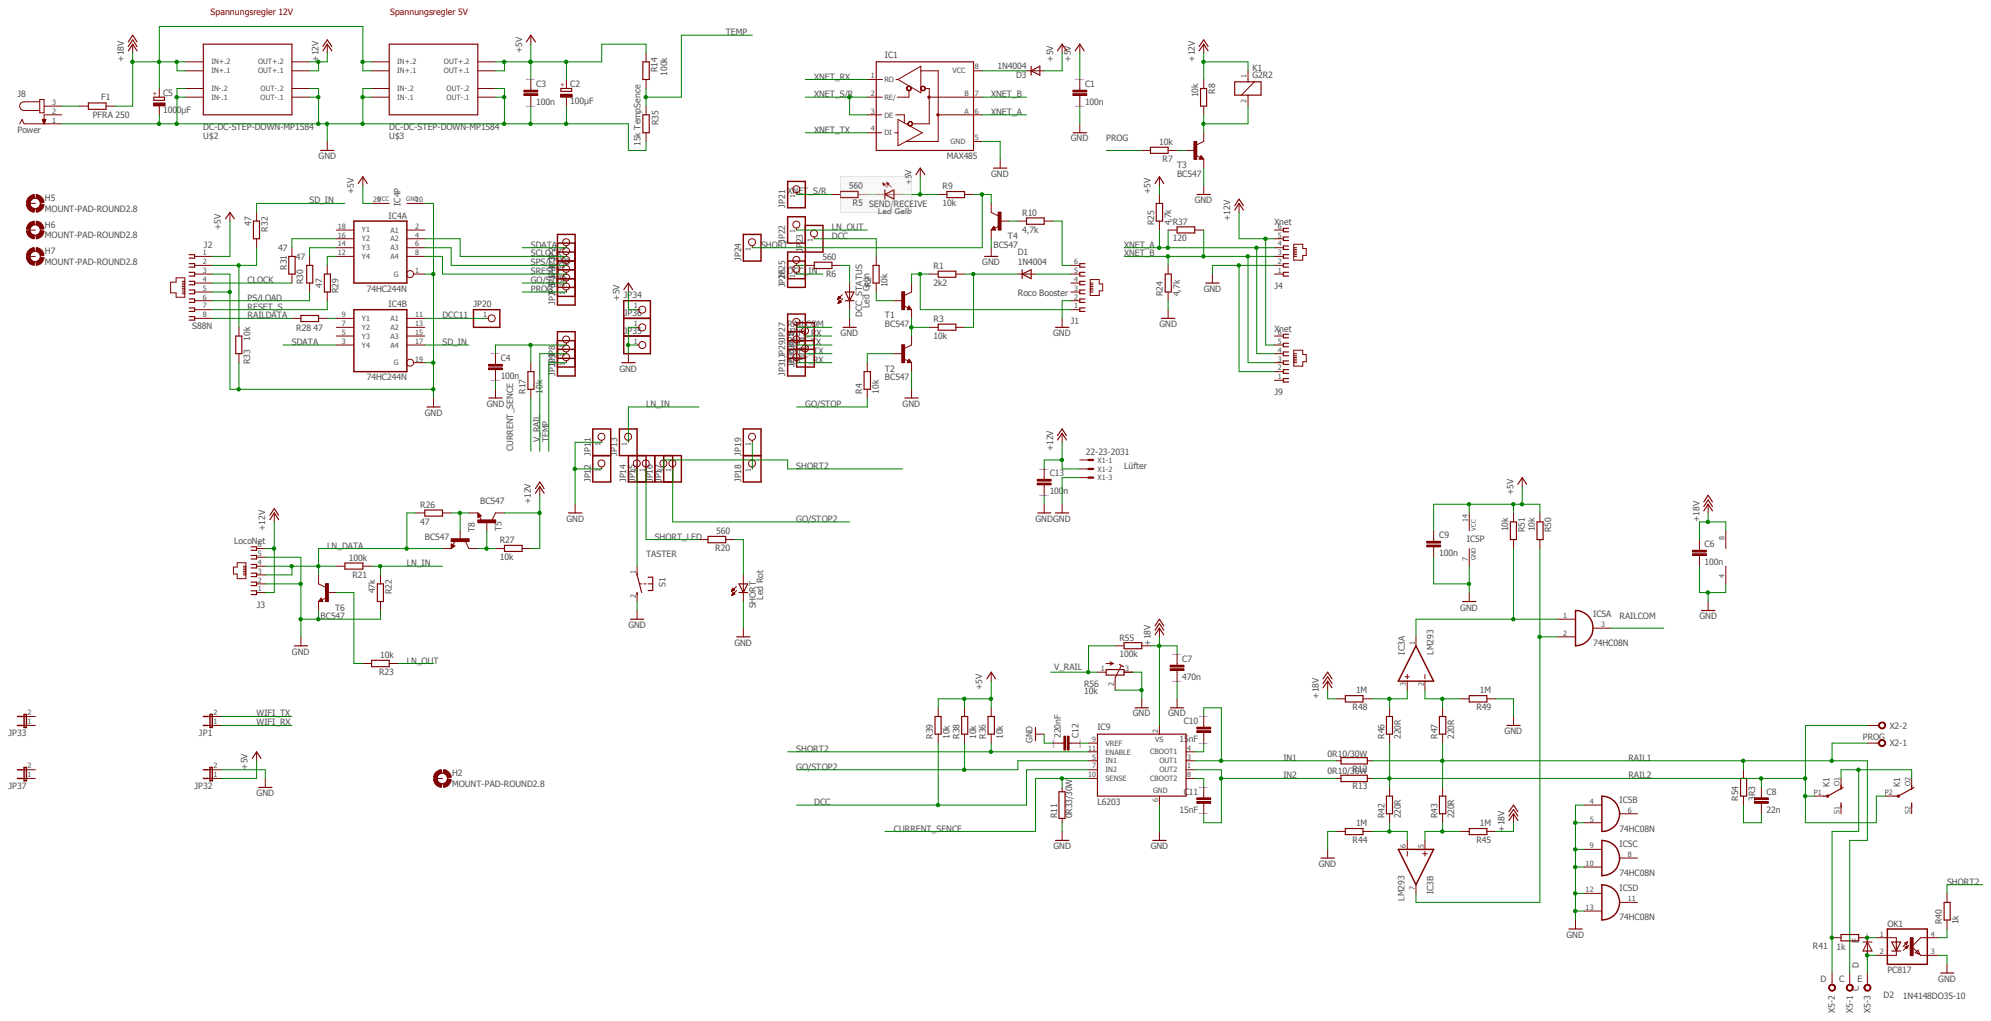
[picture p27: page 1]
