Digital-MoBa/Arduino-Z21pg-Zentrale/Baubericht von Bernd Brendel/Eagle6/Arduino-Mega-2560-Adapter_2.brd

## EAGLE design Baubericht von Bernd Brendel/Eagle6/Arduino-Mega-2560-Adapter_2.brd (2021-04-14)

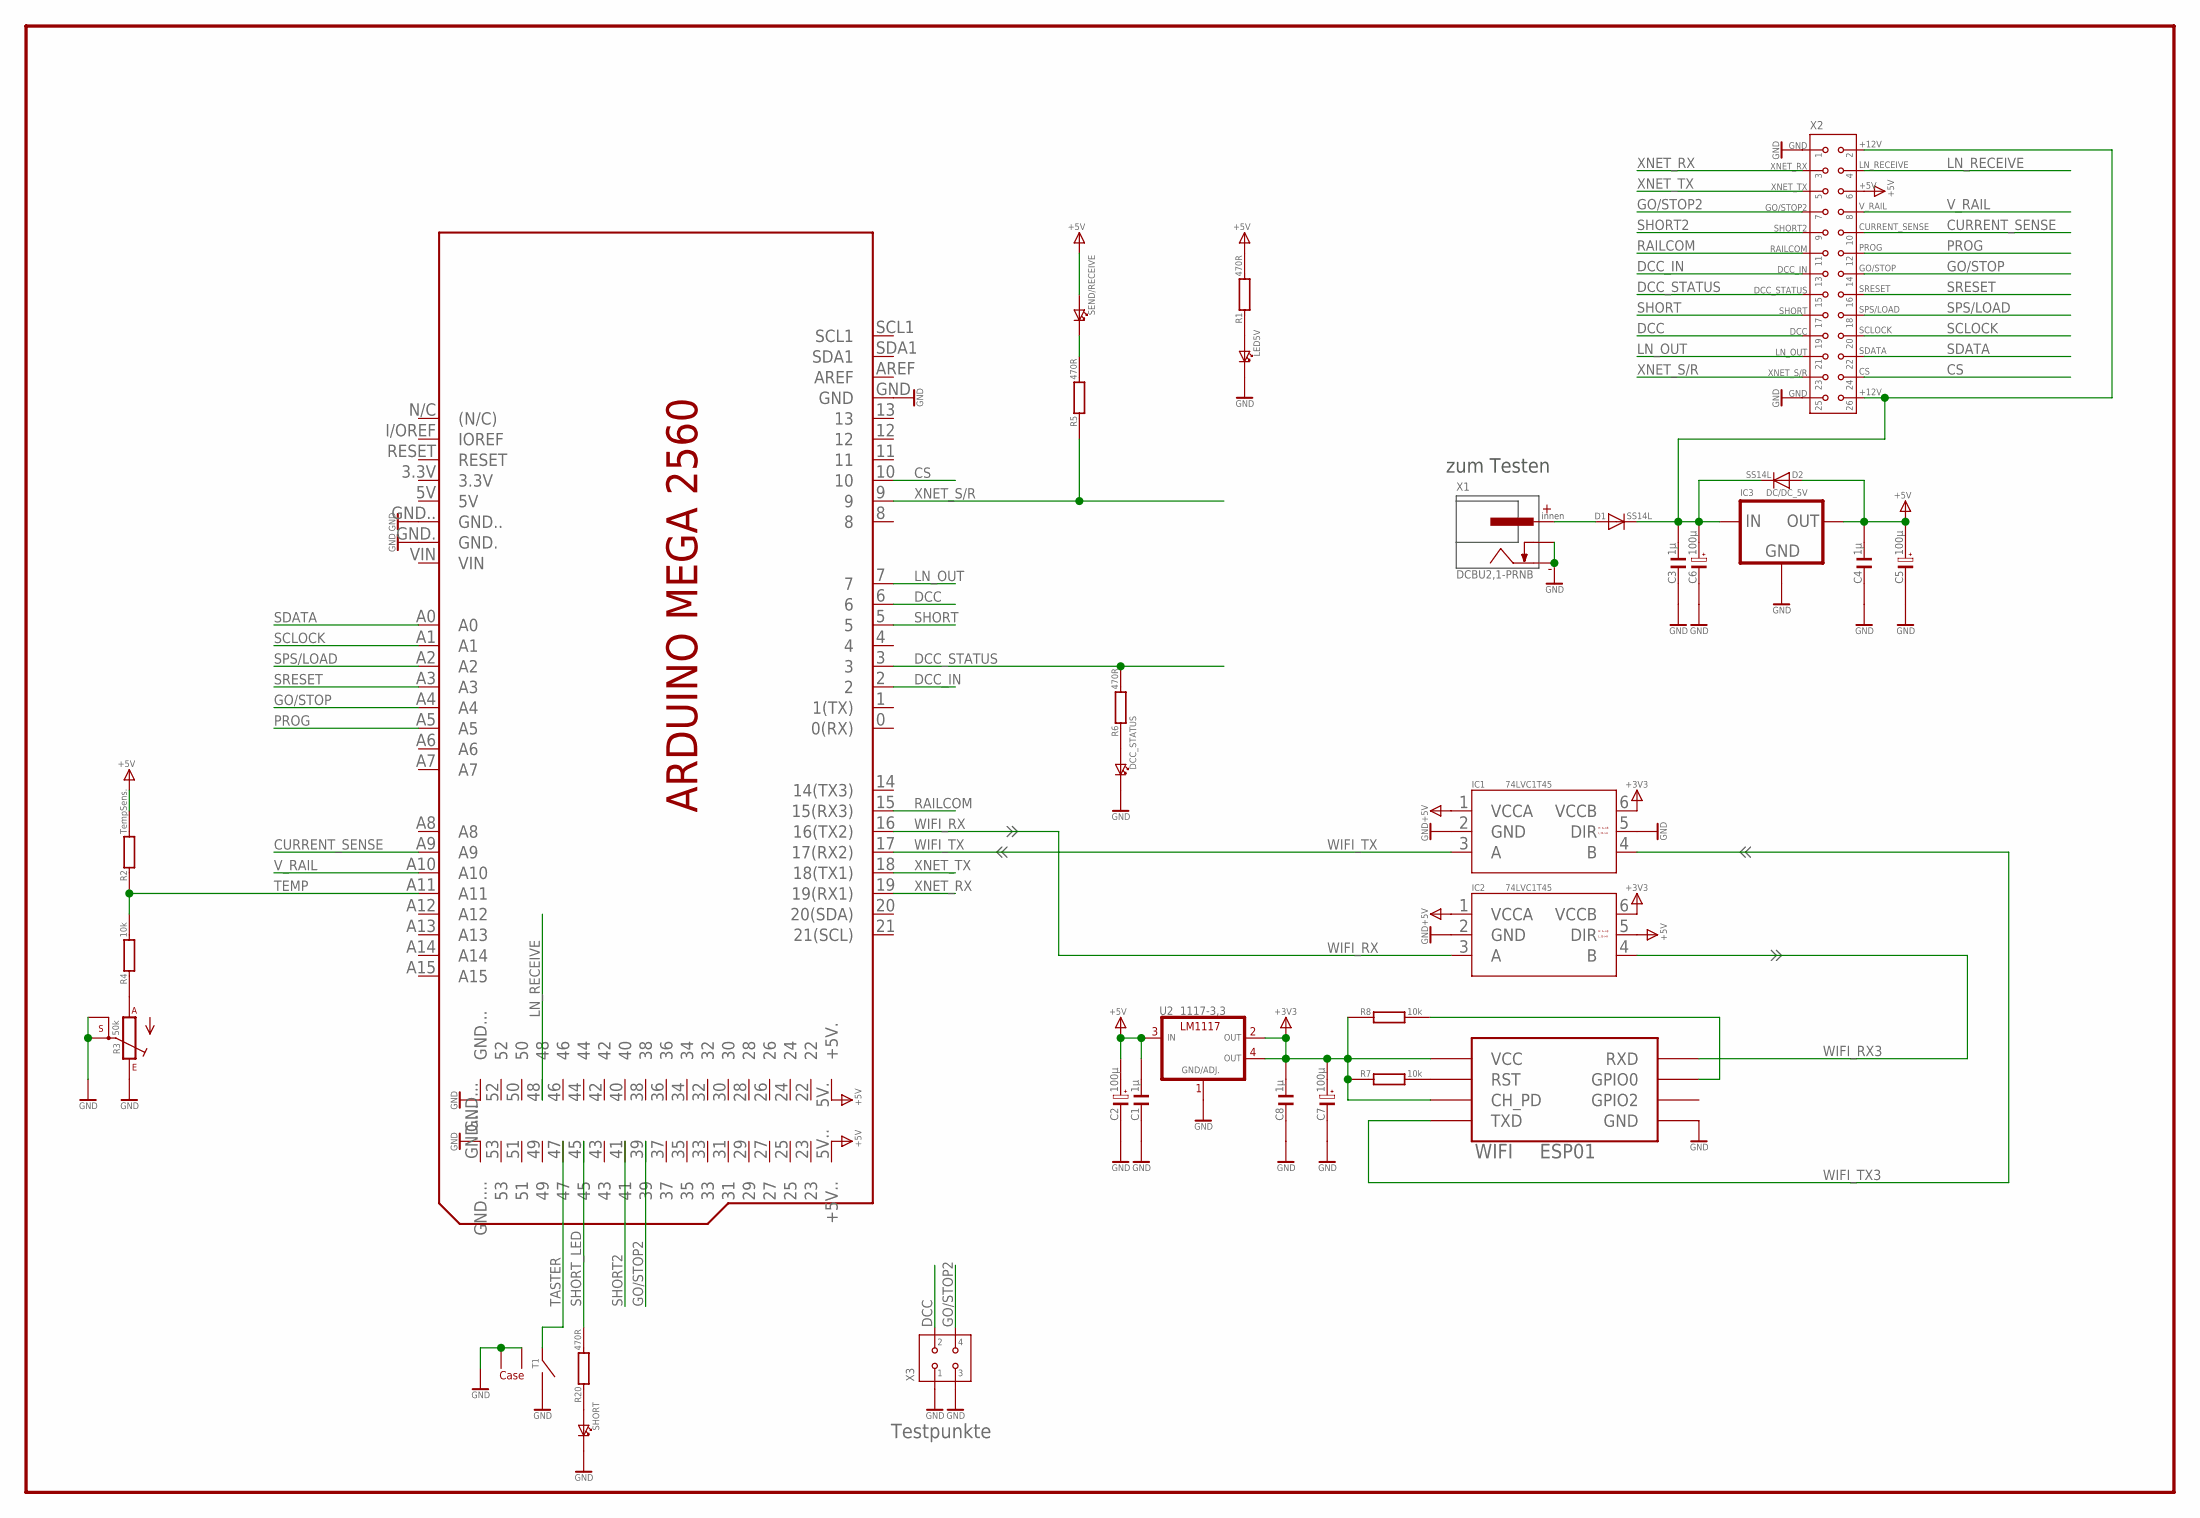
[picture p28: schematic Arduino-Mega-2560-Adapter_2.sch]

Parts:
C1, C3, C4, C8: 1µ; C0805
C2, C5, C6, C7: 100µ; RM2.5_DIA6
D1, D2: SS14L; SUB-SMA_
DCC_STATUS: LED3MM_
IC1, IC2: 74LVC1T45; SOT23-6_
IC3: DC/DC_5V; 78XXS
LED5V: LED3MM_
PCB1: ARDUINO_MEGA2560
R1, R5, R6, R20: 470R; R0805
R2: TempSens.; RM02,5
R3: 50k; S64YW
R4, R7, R8: 10k; R0603
SEND/RECEIVE: LED3MM_
SHORT: LED3MM_
T1: TACT6060-90°; TACT6060-90°_
U2: 1117-3,3; SOT223__
WIFI: ESP01
X1: DCBU2,1-PRNB
X2: 2X13_WANNE_180°
X3: 2X02_2.54MM

Connections:
+3V3: C7.PLUS, C8.2, IC1.6 (VCCB), IC2.6 (VCCB), R7.P$1, R8.P$1, U2.2 (OUT), U2.4 (OUT1), WIFI.CH_PD, WIFI.VCC
+5V: C1.2, C2.PLUS, C4.2, C5.PLUS, D2.A (ANODE), IC1.1 (VCCA), IC2.1 (VCCA), IC2.5 (DIR), IC3.OUT, PCB1.5V. (+5V.), PCB1.5V.. (+5V..), R1.P$2, R2.P$2, SEND/RECEIVE.A (ANODE), U2.3 (IN), X2.P$6
CS: PCB1.10, X2.P$24
CURRENT_SENSE: PCB1.A9, X2.P$10
DCC: PCB1.6, X2.P$19, X3.P$2
DCC_IN: PCB1.2, X2.P$13
DCC_STATUS: PCB1.3, R6.P$2, X2.P$15
GND: C1.1, C2.MINUS, C3.1, C4.1, C5.MINUS, C6.MINUS, C7.MINUS, C8.1, DCC_STATUS.K (KATHODE), IC1.2 (GND), IC1.5 (DIR), IC2.2 (GND), IC3.GND, LED5V.K (KATHODE), PCB1.GND, PCB1.GND., PCB1.GND.., PCB1.GND..., PCB1.GND...., R3.E, R3.S, R3.S@1 (S), SHORT.K (KATHODE), T1.1, T1.3 (CASE), T1.4 (CASE), U2.1 (GND), WIFI.GND, X1.AUßEN, X1.ÖFFNER, X2.P$1, X2.P$25, X3.P$1, X3.P$3
GO/STOP: PCB1.A4, X2.P$14
GO/STOP2: PCB1.39, X2.P$7, X3.P$4
LN_OUT: PCB1.7, X2.P$21
LN_RECEIVE: PCB1.48, X2.P$4
unnamed: R7.P$2, WIFI.RST
unnamed: R5.P$2, SEND/RECEIVE.K (KATHODE)
unnamed: DCC_STATUS.A (ANODE), R6.P$1
unnamed: R20.P$1, SHORT.A (ANODE)
unnamed: LED5V.A (ANODE), R1.P$1
unnamed: R8.P$2, WIFI.GPIO0
unnamed: C3.2, C6.PLUS, D1.K (KATHODE), D2.K (KATHODE), IC3.IN, X2.P$2, X2.P$26
unnamed: D1.A (ANODE), X1.INNEN
unnamed: R3.A, R4.P$1
PROG: PCB1.A5, X2.P$12
RAILCOM: PCB1.15 (15(RX3)), X2.P$11
SCLOCK: PCB1.A1, X2.P$20
SDATA: PCB1.A0, X2.P$22
SHORT: PCB1.5, X2.P$17
SHORT2: PCB1.41, X2.P$9
SHORT_LED: PCB1.45, R20.P$2
SPS/LOAD: PCB1.A2, X2.P$18
SRESET: PCB1.A3, X2.P$16
TASTER: PCB1.47, T1.2
TEMP: PCB1.A11, R2.P$1, R4.P$2
V_RAIL: PCB1.A10, X2.P$8
WIFI_RX: IC2.3 (A), PCB1.16 (16(TX2))
WIFI_RX3: IC2.4 (B), WIFI.RX (RXD)
WIFI_TX: IC1.3 (A), PCB1.17 (17(RX2))
WIFI_TX3: IC1.4 (B), WIFI.TX (TXD)
XNET_RX: PCB1.19 (19(RX1)), X2.P$3
XNET_S/R: PCB1.9, R5.P$1, X2.P$23
XNET_TX: PCB1.18 (18(TX1)), X2.P$5

Notes on the sheet:
Testpunkte
zum Testen

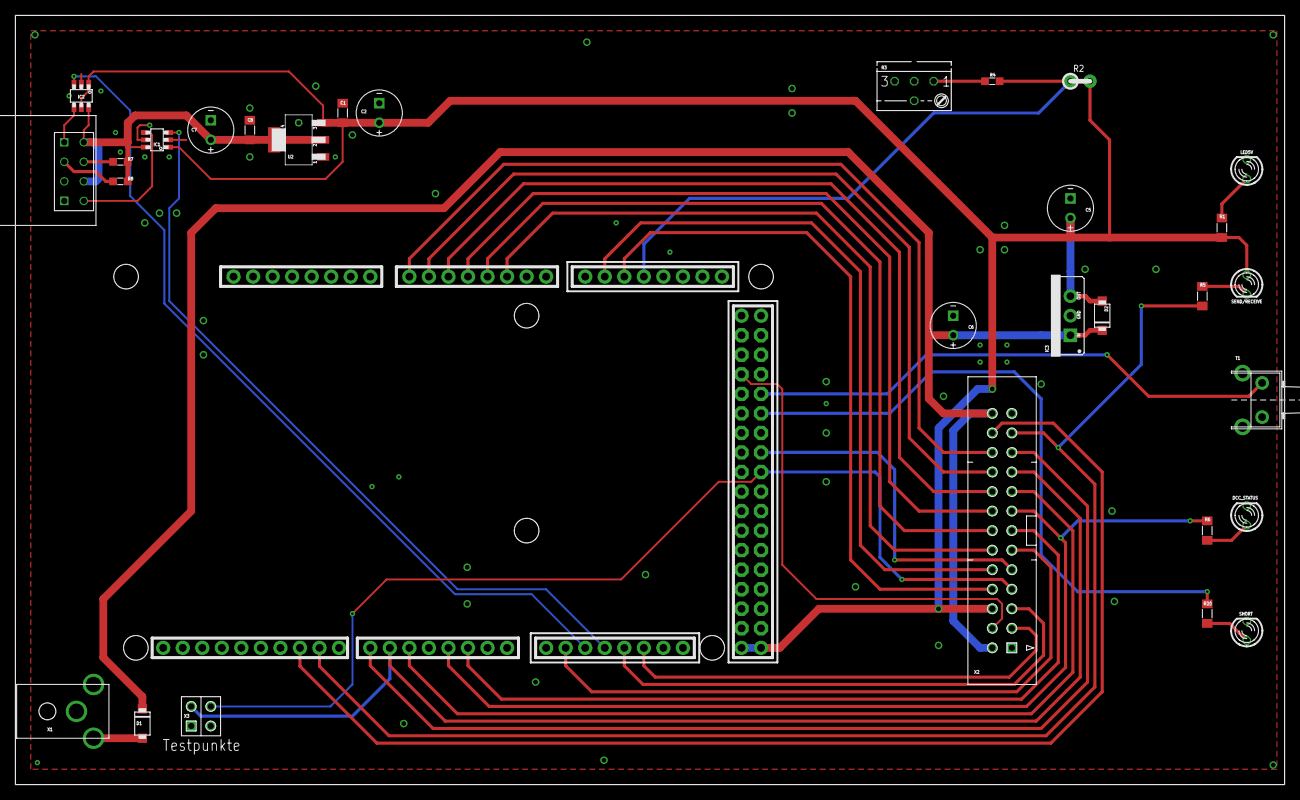
[picture p29: board Arduino-Mega-2560-Adapter_2.brd from above]

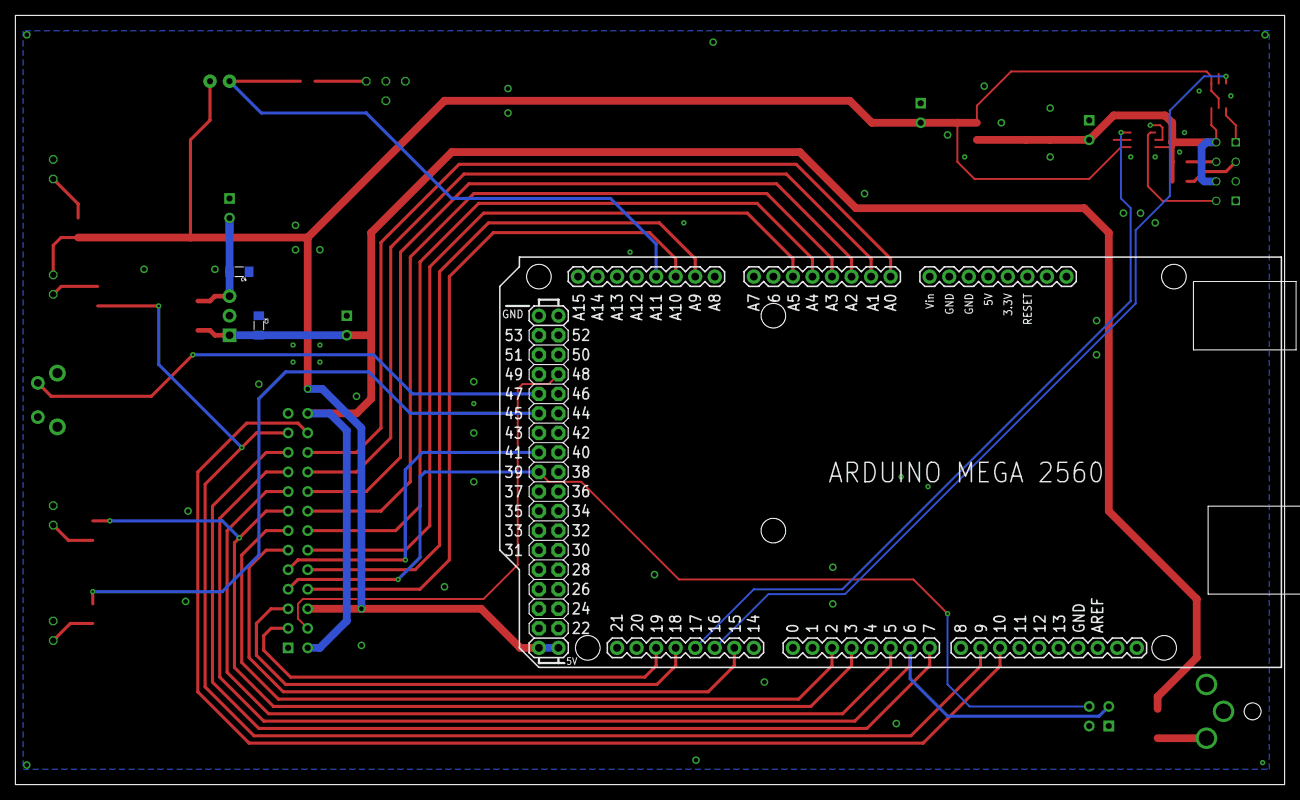
[picture p30: board Arduino-Mega-2560-Adapter_2.brd from below]

Board: 2 copper layers, 165.0 x 100.0 mm, 33 parts (3 on the bottom side), 40 nets.
