Digital-MoBa/Arduino-Z21pg-Zentrale/Aufbau Andreas Schreiber/z21_2020_3.brd

## EAGLE design Aufbau Andreas Schreiber/z21_2020_3.brd (2021-04-14)

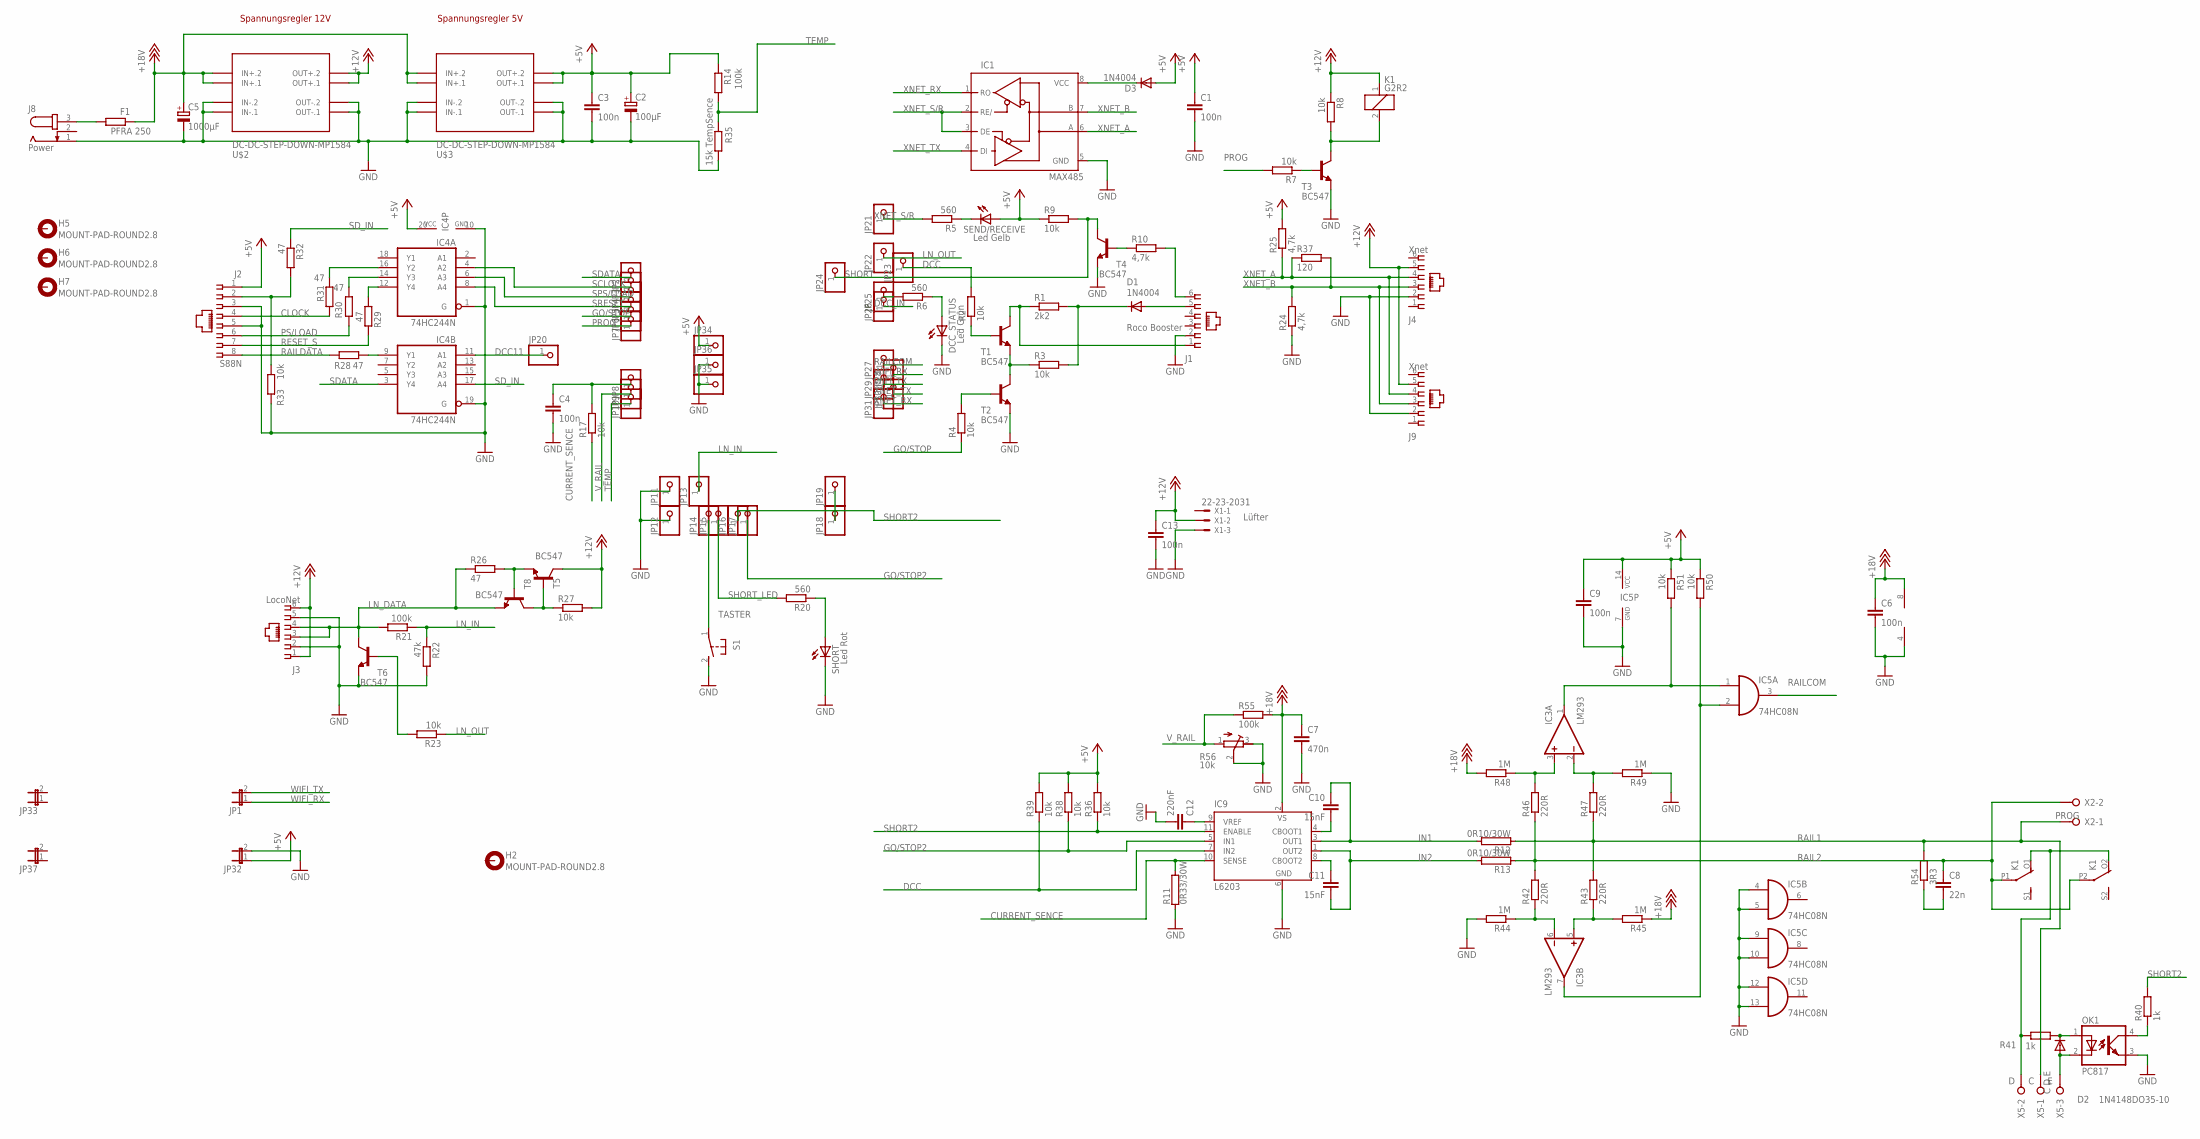
[picture p31: schematic z21_2020_3.sch]

Parts:
C1, C3, C4, C6, C9, C13: 100n; C050-024X044
C2: 100µF; E3,5-10
C5: 1000µF; E5-13
C7: 470n; C050-024X044
C8: 22n; C050-024X044
C10, C11: 15nF; C050-025X075
C12: 220nF; C050-025X075
D1, D3: 1N4004; DO41-10
D2: 1N4148DO35-10; DO35-10
DCC_STATUS: Led Grün; LD260
F1: PFRA 250; 0204/5
H2, H5, H6, H7: MOUNT-PAD-ROUND2.8; 2,8-PAD
IC1: MAX485; DIL08
IC3: LM293; DIL08
IC4: 74HC244N; DIL20
IC5: 74HC08N; DIL14
IC9: L6203; MULTIWATT-11
J1: Roco Booster; 520250-3
J2: S88N; 520251-4
J3: LocoNet; 520250-3
J4, J9: Xnet; 520250-3
J8: Power; SPC4077
JP1, JP32, JP33, JP37: JP1E; JP1
JP2, JP3, JP4, JP5, JP6, JP7, JP8, JP9, JP10, JP11, JP12, JP13, JP14, JP15, JP16, JP17, JP18, JP19, JP20, JP21, JP22, JP23, JP24, JP25, JP26, JP27, JP28, JP29, JP30, JP31, JP34, JP35, JP36: PINHD-1X1; 1X01
K1: G2R2
OK1: PC817; DIL04
R1: 2k2; 0204/7
R2: 10k; 0204/7
R3, R7, R8, R9, R17, R23, R27, R33, R36, R38, R39, R50, R51: 10k; 0207/10
R4: 10k; 0207/15
R5, R6, R20: 560; 0204/7
R10: 4,7k; 0204/7
R11: 0R33/30W; MNS-2
R12, R13: 0R10/30W; MNS-2
R14, R21: 100k; 0207/10
R22: 47k; 0207/10
R24, R25: 4,7k; 0207/10
R26: 47; 0204/7
R28, R29, R30, R31, R32: 47; 0207/10
R35: 15k TempSence; 0204/7
R37: 120; 0207/10
R40, R41: 1k; 0207/10
R42, R43, R46, R47: 220R; 0207/10
R44, R45, R48, R49: 1M; 0207/10
R54: 3R3; 0204/7
R55: 100k; 0207/12
R56: 10k; RTRIM64X
S1: 31-XX; B3F-31XX
SEND/RECEIVE: Led Gelb; LD260
SHORT: Led Rot; LD260
T1, T2, T3, T4, T5, T6, T8: BC547; TO92
U$2, U$3: DC-DC-STEP-DOWN-MP1584
X1: 22-23-2031
X2: PROG; W237-132
X5: C D E; W237-3E

Connections:
+5V: C1.1, C2.+, C3.1, C9.1, D3.A, IC4.20 (VCC), IC5.14 (VCC), J2.1, JP32.1, JP34.1, R9.1, R14.1, R25.2, R36.2, R38.2, R39.2, R50.1, R51.1, SEND/RECEIVE.A, U$3.OUT+.1, U$3.OUT+.2
+12V: C13.1, J3.1, J3.6, J4.5, J9.5, K1.1, R8.1, R27.2, T5.3 (C), U$2.OUT+.1, U$2.OUT+.2, X1.2
+18V: C5.+, C6.1, C7.1, F1.1, IC3.8 (V+), IC9.2 (VS), R45.1, R48.2, R55.2, U$2.IN+.1, U$2.IN+.2, U$3.IN+.1, U$3.IN+.2
CLOCK: J2.4, R31.2
CURRENT_SENCE: IC9.10 (SENSE), R11.2, R17.1
DCC: IC9.7 (IN2), JP23.1, R2.2, R39.1
DCC11: IC4.11 (A1), JP20.1
DCC_IN: JP26.1
GND: C1.2, C2.-, C3.2, C4.2, C5.-, C6.2, C7.2, C9.2, C12.2, C13.2, DCC_STATUS.K (C), IC1.5 (GND), IC3.4 (V-), IC4.1 (G), IC4.10 (GND), IC4.19 (G), IC5.4 (I0), IC5.5 (I1), IC5.7 (GND), IC5.9 (I0), IC5.10 (I1), IC5.12 (I0), IC5.13 (I1), IC9.6 (GND), J1.2, J2.3, J2.5, J3.2, J3.5, J4.2, J8.1, J9.2, JP11.1, JP12.1, JP32.2, JP35.1, JP36.1, OK1.3 (EMIT), R11.1, R22.2, R24.1, R33.2, R35.2, R44.2, R49.1, R56.2 (S), R56.3 (E), S1.2 (S), SHORT.K (C), T2.1 (E), T3.1 (E), T4.1 (E), T6.1 (E), U$2.IN-.1, U$2.IN-.2, U$2.OUT-.1, U$2.OUT-.2, U$3.IN-.1, U$3.IN-.2, U$3.OUT-.1, U$3.OUT-.2, X1.3
GO/STOP: JP6.1, R4.1
GO/STOP2: IC9.5 (IN1), JP17.1, R38.1
IN1: C10.1, IC9.3 (OUT1), R12.2
IN2: C11.2, IC9.1 (OUT2), R13.2
LN_DATA: J3.3, J3.4, R21.2, R26.1, T6.3 (C), T8.1 (E)
LN_IN: JP13.1, R21.1, R22.1
LN_OUT: JP22.1, R23.1
unnamed: J1.6, R10.2
unnamed: D1.C, R1.2, R3.2
unnamed: D1.A, J1.5
unnamed: R2.1, T1.2 (B)
unnamed: R3.1, T1.1 (E), T2.3 (C)
unnamed: J1.1, R1.1, T1.3 (C)
unnamed: JP25.1, R6.2
unnamed: F1.2, J8.3
unnamed: R4.2, T2.2 (B)
unnamed: DCC_STATUS.A, R6.1
unnamed: R5.1, SEND/RECEIVE.K (C)
unnamed: D3.C, IC1.8 (VCC)
unnamed: K1.2, R8.2, T3.3 (C)
unnamed: R7.1, T3.2 (B)
unnamed: R10.1, T4.2 (B)
unnamed: JP18.1, JP19.1
unnamed: R20.1, SHORT.A
unnamed: C4.1, JP8.1, R17.2
unnamed: K1.O1 (O), K1.O2 (O), R41.2, X5.2
unnamed: D2.C, OK1.1 (A), R41.1
unnamed: R26.2, T5.1 (E), T8.2 (B)
unnamed: R23.2, T6.2 (B)
unnamed: D2.A, OK1.2 (C), X5.3
unnamed: R27.1, T5.2 (B), T8.3 (C)
unnamed: IC4.9 (Y1), R28.2
unnamed: IC4.14 (Y3), R30.1
unnamed: IC4.16 (Y2), R31.1
unnamed: IC4.12 (Y4), R29.1
unnamed: IC3.6 (-IN), R42.1, R44.1
unnamed: J2.2, R32.2, R33.1
unnamed: IC3.5 (+IN), R43.1, R45.2
unnamed: IC3.7 (OUT), IC5.2 (I1), R50.2
unnamed: IC3.3 (+IN), R46.2, R48.1
unnamed: IC3.2 (-IN), R47.2, R49.2
unnamed: OK1.4 (COL), R40.1
unnamed: IC3.1 (OUT), IC5.1 (I0), R51.2
unnamed: C10.2, IC9.4 (CBOOT1)
unnamed: C8.2, R54.1
unnamed: C11.1, IC9.8 (CBOOT2)
unnamed: C12.1, IC9.9 (VREF)
PROG: JP7.1, R7.2
PS/LOAD: J2.6, R30.2
RAIL1: R12.1, R43.2, R47.1, R54.2, X2.1, X5.1
RAIL2: C8.1, K1.P1, K1.P2, R13.1, R42.2, R46.1, X2.2
RAILCOM: IC5.3 (O), JP27.1
RAILDATA: J2.8, R28.1
RESET_S: J2.7, R29.2
SCLOCK: IC4.4 (A2), JP3.1
SDATA: IC4.3 (Y4), JP2.1
SD_IN: IC4.17 (A4), R32.1
SHORT: JP24.1, R9.2, T4.3 (C)
SHORT2: IC9.11 (ENABLE), JP16.1, R36.1, R40.2
SHORT_LED: JP15.1, R20.2
SPS/LOAD: IC4.6 (A3), JP4.1
SRESET: IC4.8 (A4), JP5.1
TASTER: JP14.1, S1.1
TEMP: JP10.1, R14.2, R35.1
V_RAIL: JP9.1, R55.1, R56.1 (A)
WIFI_RX: JP1.1, JP28.1
WIFI_TX: JP1.2, JP29.1
XNET_A: IC1.6 (A), J4.4, J9.4, R25.1, R37.1
XNET_B: IC1.7 (B), J4.3, J9.3, R24.2, R37.2
XNET_RX: IC1.1 (RO), JP31.1
XNET_S/R: IC1.2 (RE/), IC1.3 (DE), JP21.1, R5.2
XNET_TX: IC1.4 (DI), JP30.1

Notes on the sheet:
Spannungsregler 12V
Spannungsregler 5V
D C E
Lüfter

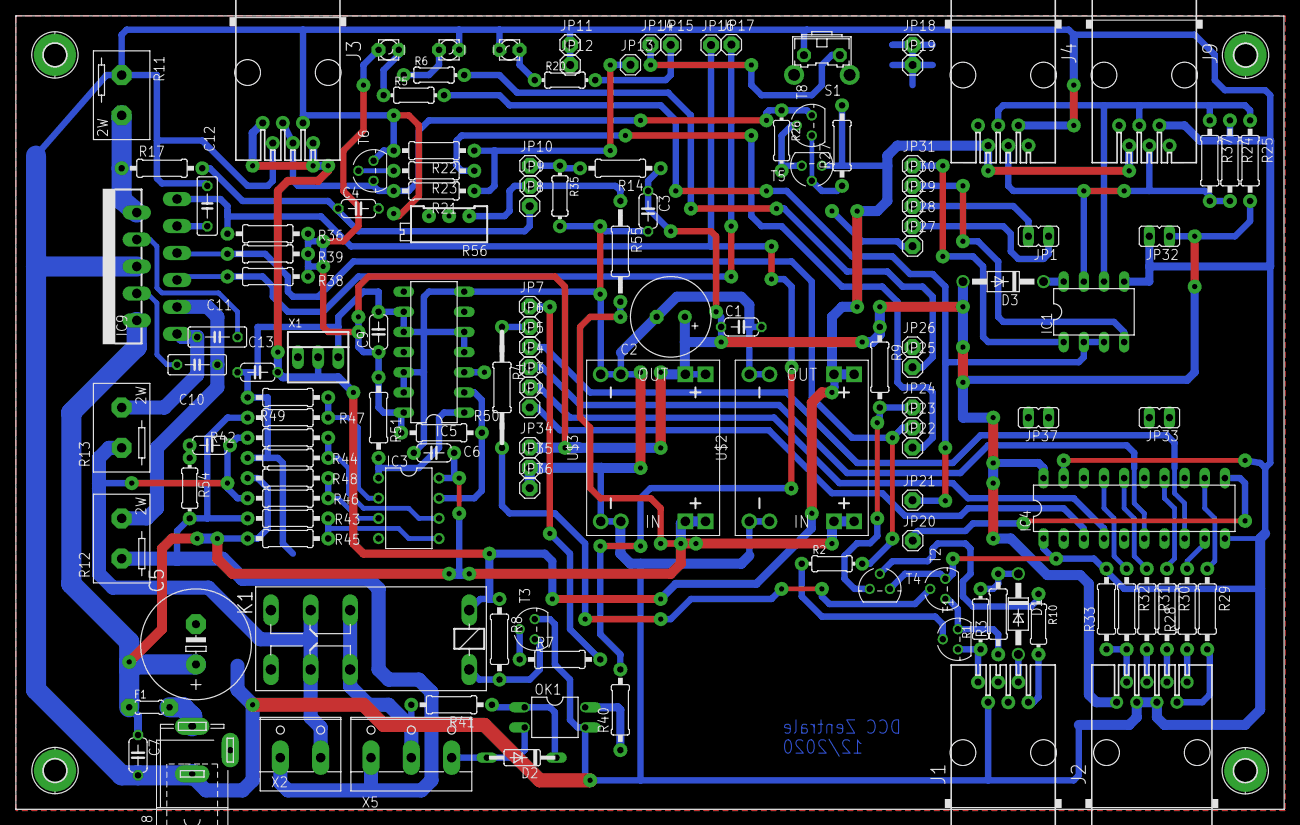
[picture p32: board z21_2020_3.brd from above]

Board: 2 copper layers, 159.9 x 100.0 mm, 136 parts (0 on the bottom side), 80 nets.
