Digital-MoBa/Arduino-Z21pg-Zentrale/Baubericht von Bernd Brendel/Eagle6/Z21 MEGA_2.brd

## EAGLE design Baubericht von Bernd Brendel/Eagle6/Z21 MEGA_2.brd (2021-04-14)

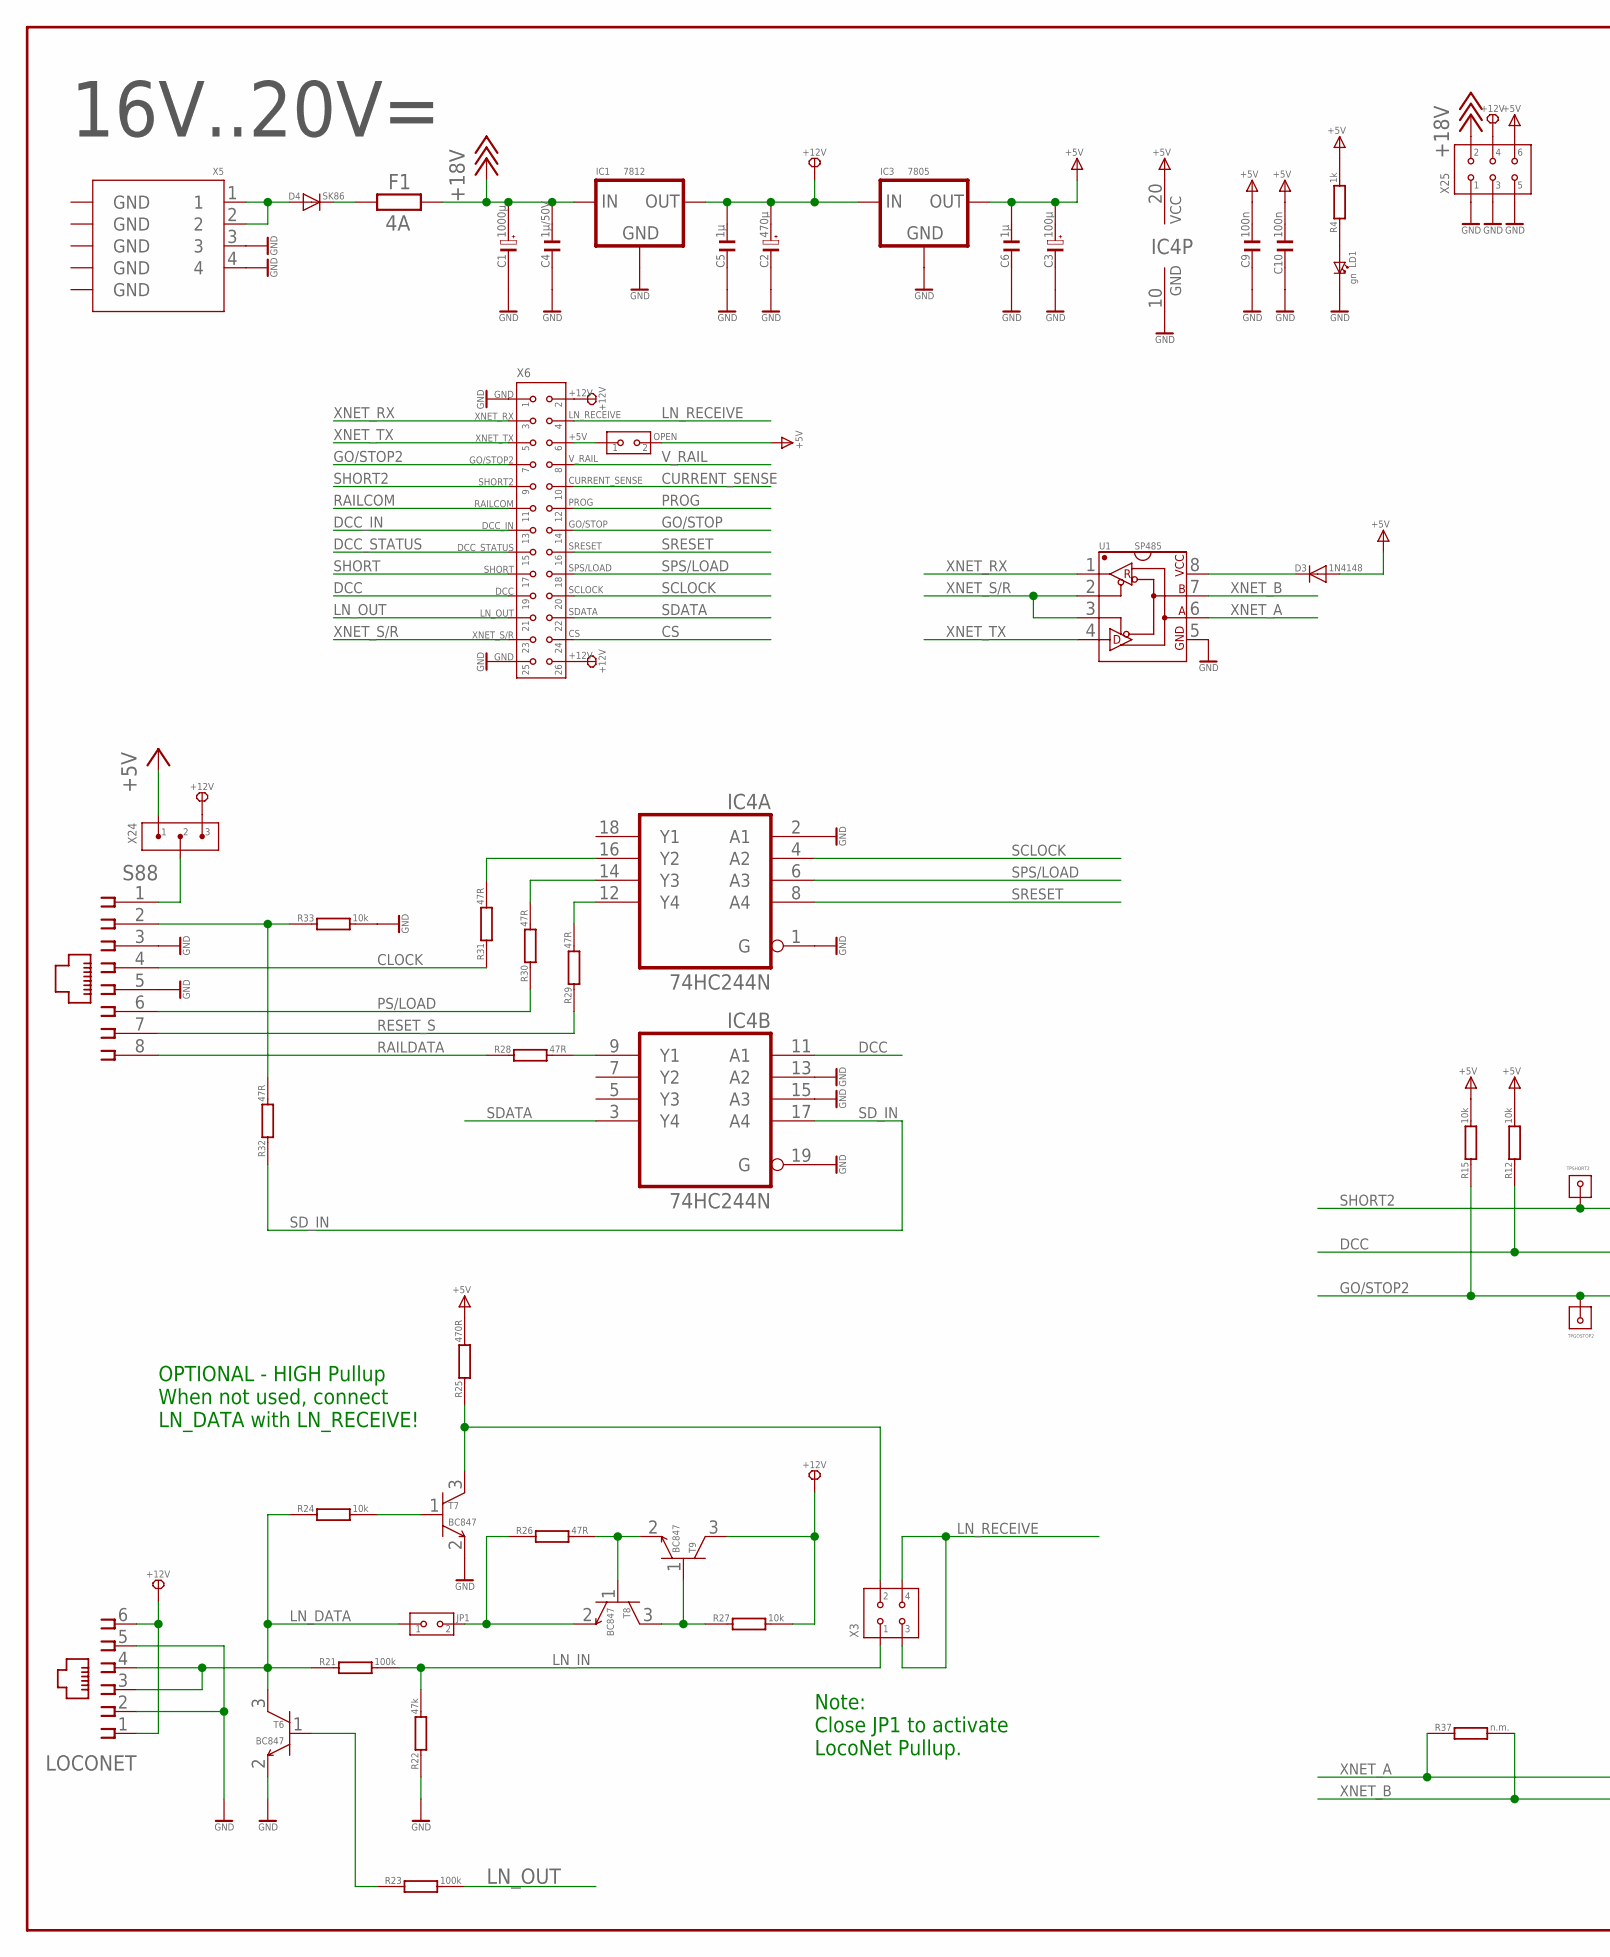
[picture p33: schematic Z21 MEGA_2.sch, part in row 1, column 1]

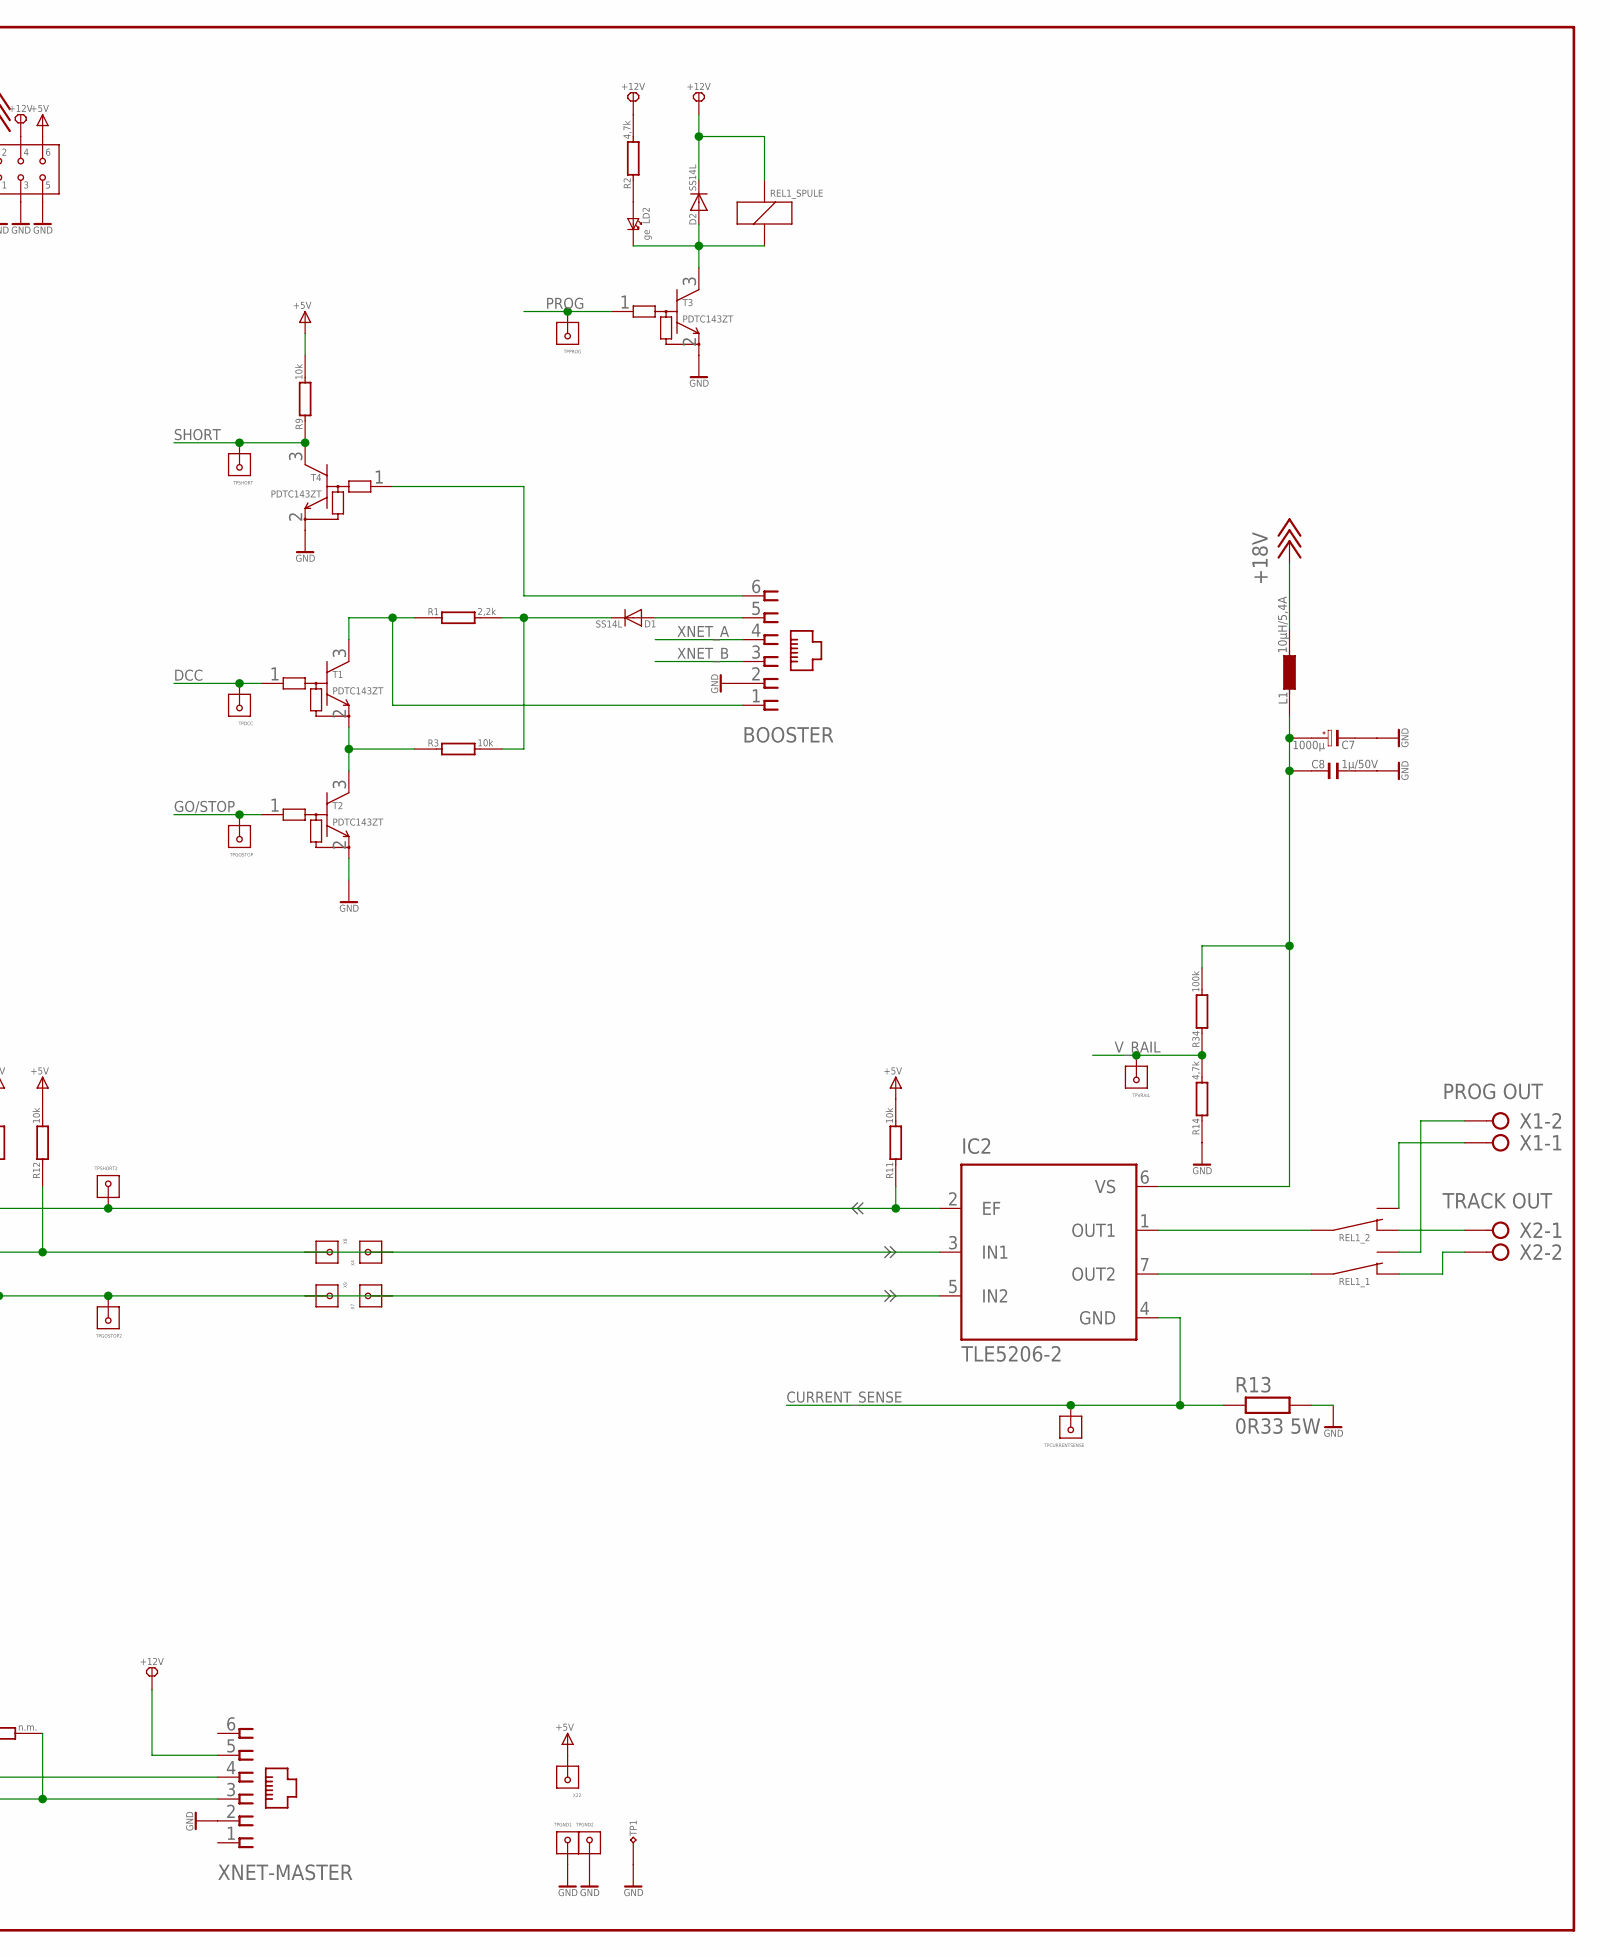
[picture p34: schematic Z21 MEGA_2.sch, part in row 1, column 2]

Parts:
BOOSTER: 520250-3
C1, C7: 1000µ; RM5_DIA12.5
C2: 470µ; RM5_DIA10
C3: 100µ; RM2.5_DIA6
C4, C8: 1µ/50V; C0805
C5, C6: 1µ; C0805
C9, C10: 100n; C0805
D1, D2: SS14L; SUB-SMA_
D3: 1N4148; SOD323_
D4: SK86; SMC_
F1: 4A; 0204/5
IC1: 7812; 78XXS
IC2: TLE5206-2; P-TO220-7-11
IC3: 7805; 78XXS
IC4: 74HC244N; DIL20
JP1: 1X02_JUMPER_2.54MM; 1X02_2.54MM
L1: 10µH/5,4A; 12,5X12,5MM
LD1: gn; LED3MM_
LD2: ge; LED3MM_
LOCONET: 520250-3
OPEN: 1X02_JUMPER_2.54MM; 1X02_2.54MM
R1: 2,2k; R0805
R2, R14: 4,7k; R0805
R3, R9, R11, R12, R15, R24, R27, R33: 10k; R0805
R4: 1k; R0805
R13: 0R33 5W; VMTA55
R21, R23, R34: 100k; R0805
R22: 47k; R0805
R25: 470R; R0805
R26, R28, R29, R30, R31, R32: 47R; R0805
R37: n.m.; R0805
REL1: DIL16_1FINDER_40.527; FINDER_40.527
S88: 520251-4
T1, T2, T3, T4: PDTC143ZT; SOT23_
T6, T7, T8, T9: BC847; SOT23_
TP1: LÖTPUNKTTHT_1.3MM_51.2MIL; THT_1.3MM_51.2MIL
TPCURRENTSENSE: 1X01_2.54MM
TPDCC: 1X01_2.54MM
TPGND1, TPGND2: 1X01_2.54MM
TPGOSTOP, TPGOSTOP2: 1X01_2.54MM
TPPROG: 1X01_2.54MM
TPSHORT, TPSHORT2: 1X01_2.54MM
TPVRAIL: 1X01_2.54MM
U1: SP485; SO8__
X1: PROG OUT; W237-132
X2: TRACK OUT; W237-132
X3: 2X02_2.54MM
X4, X7, X8, X9, X22: 1X01_2.54MM
X5: MDINBU4-POWER
X6: 2X13_WANNE_180°
X24: 1X03T2,54MM; 1X03_2.54MM
X25: 2X03_2.54MM
XNET-MASTER: 520250-3

Connections:
+5V: C3.PLUS, C6.2, C9.2, C10.2, D3.ANODE, IC3.OUT, IC4.20 (VCC), OPEN.P$2, R4.P$2, R9.P$2, R11.P$2, R12.P$2, R15.P$2, R25.P$2, X22.P$1, X24.P$1, X25.P$6
+12V: C2.PLUS, C5.2, D2.K (KATHODE), IC1.OUT, IC3.IN, LOCONET.1, LOCONET.6, R2.P$2, R27.P$2, REL1.SP1 (+), T9.3 (C), X6.P$2, X6.P$26, X24.P$3, X25.P$4, XNET-MASTER.5
+18V: C1.PLUS, C4.2, F1.1, IC1.IN, L1.P$2, X25.P$2
CLOCK: R31.P$1, S88.4
CS: X6.P$24
CURRENT_SENSE: IC2.4 (GND), R13.1, TPCURRENTSENSE.P$1, X6.P$10
DCC: IC2.3 (IN1), IC4.11 (A1), R12.P$1, T1.1 (B), TPDCC.P$1, X4.P$1, X6.P$19, X8.P$1
DCC_IN: X6.P$13
DCC_STATUS: X6.P$15
GND: BOOSTER.2, C1.MINUS, C2.MINUS, C3.MINUS, C4.1, C5.1, C6.1, C7.MINUS, C8.2, C9.1, C10.1, IC1.GND, IC3.GND, IC4.1 (G), IC4.2 (A1), IC4.10 (GND), IC4.13 (A2), IC4.15 (A3), IC4.19 (G), LD1.K (KATHODE), LOCONET.2, LOCONET.5, R13.2, R14.P$1, R22.P$1, R33.P$2, S88.3, S88.5, T2.2 (E), T3.2 (E), T4.2 (E), T6.2 (E), T7.2 (E), TP1.P$1, TPGND1.P$1, TPGND2.P$1, U1.5, X5.3, X5.4, X6.P$1, X6.P$25, X25.P$1, X25.P$3, X25.P$5, XNET-MASTER.2
GO/STOP: T2.1 (B), TPGOSTOP.P$1, X6.P$14
GO/STOP2: IC2.5 (IN2), R15.P$1, TPGOSTOP2.P$1, X6.P$7, X7.P$1, X9.P$1
LN_DATA: JP1.P$1, LOCONET.3, LOCONET.4, R21.P$1, R24.P$1, T6.3 (C)
LN_IN: R21.P$2, R22.P$2, X3.P$1
LN_OUT: R23.P$2, X6.P$21
LN_RECEIVE: X3.P$3, X3.P$4, X6.P$4
unnamed: OPEN.P$1, X6.P$6
unnamed: D1.K (KATHODE), R1.P$2, R3.P$2
unnamed: IC2.7 (OUT2), REL1.P1
unnamed: IC2.1 (OUT1), REL1.P2
unnamed: R3.P$1, T1.2 (E), T2.3 (C)
unnamed: REL1.Ö2 (Ö), X2.1
unnamed: D4.K (KATHODE), F1.2
unnamed: D4.A (ANODE), X5.1, X5.2
unnamed: C7.PLUS, C8.1, IC2.6 (VS), L1.P$1, R34.P$2
unnamed: D3.KATHODE, U1.8
unnamed: D2.A (ANODE), LD2.K (KATHODE), REL1.SP2 (-), T3.3 (C)
unnamed: REL1.Ö1 (Ö), X2.2
unnamed: REL1.S2 (S), X1.1
unnamed: REL1.S1 (S), X1.2
unnamed: R26.P$2, T8.1 (B), T9.2 (E)
unnamed: R23.P$1, T6.1 (B)
unnamed: R24.P$2, T7.1 (B)
unnamed: R27.P$1, T8.3 (C), T9.1 (B)
unnamed: IC4.9 (Y1), R28.P$2
unnamed: IC4.14 (Y3), R30.P$2
unnamed: IC4.16 (Y2), R31.P$2
unnamed: IC4.12 (Y4), R29.P$2
unnamed: R32.P$2, R33.P$1, S88.2
unnamed: JP1.P$2, R26.P$1, T8.2 (E)
unnamed: S88.1, X24.P$2
unnamed: BOOSTER.6, T4.1 (B)
unnamed: BOOSTER.1, R1.P$1, T1.3 (C)
unnamed: LD2.A (ANODE), R2.P$1
unnamed: LD1.A (ANODE), R4.P$1
unnamed: R25.P$1, T7.3 (C), X3.P$2
unnamed: BOOSTER.5, D1.A (ANODE)
PROG: T3.1 (B), TPPROG.P$1, X6.P$12
PS/LOAD: R30.P$1, S88.6
RAILCOM: X6.P$11
RAILDATA: R28.P$1, S88.8
RESET_S: R29.P$1, S88.7
SCLOCK: IC4.4 (A2), X6.P$20
SDATA: IC4.3 (Y4), X6.P$22
SD_IN: IC4.17 (A4), R32.P$1
SHORT: R9.P$1, T4.3 (C), TPSHORT.P$1, X6.P$17
SHORT2: IC2.2 (EF), R11.P$1, TPSHORT2.P$1, X6.P$9
SPS/LOAD: IC4.6 (A3), X6.P$18
SRESET: IC4.8 (A4), X6.P$16
V_RAIL: R14.P$2, R34.P$1, TPVRAIL.P$1, X6.P$8
XNET_A: BOOSTER.4, R37.P$1, U1.6, XNET-MASTER.4
XNET_B: BOOSTER.3, R37.P$2, U1.7, XNET-MASTER.3
XNET_RX: U1.1, X6.P$3
XNET_S/R: U1.2, U1.3, X6.P$23
XNET_TX: U1.4, X6.P$5

Notes on the sheet:
OPTIONAL - HIGH Pullup When not used, connect LN_DATA with LN_RECEIVE!
Note: Close JP1 to activate LocoNet Pullup.
16V..20V=
