Digital-MoBa/Arduino-Z21pg-Zentrale/Baubericht von Bernd Brendel/Eagle6/Z21 MEGA_2.brd

## EAGLE design Baubericht von Bernd Brendel/Eagle6/Z21 MEGA_2.brd (continued)

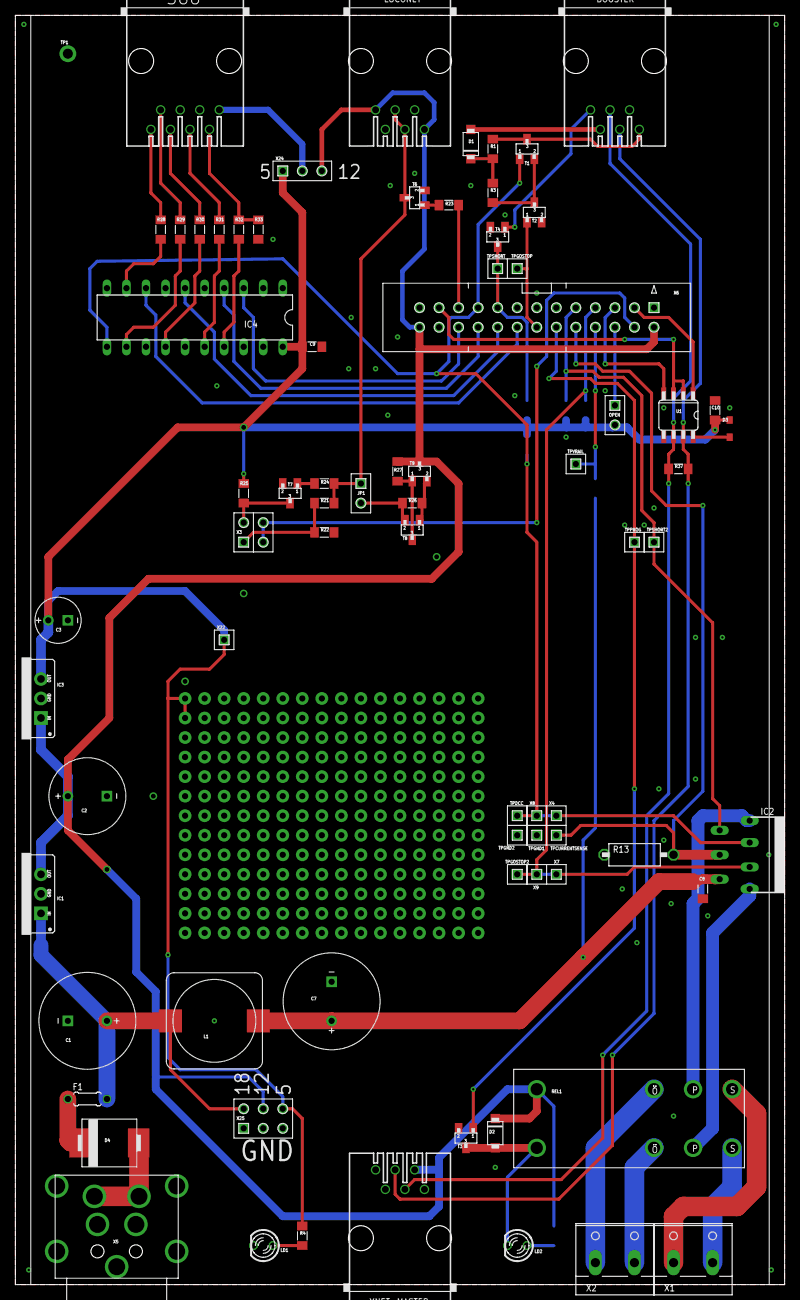
[picture p35: board Z21 MEGA_2.brd from above]

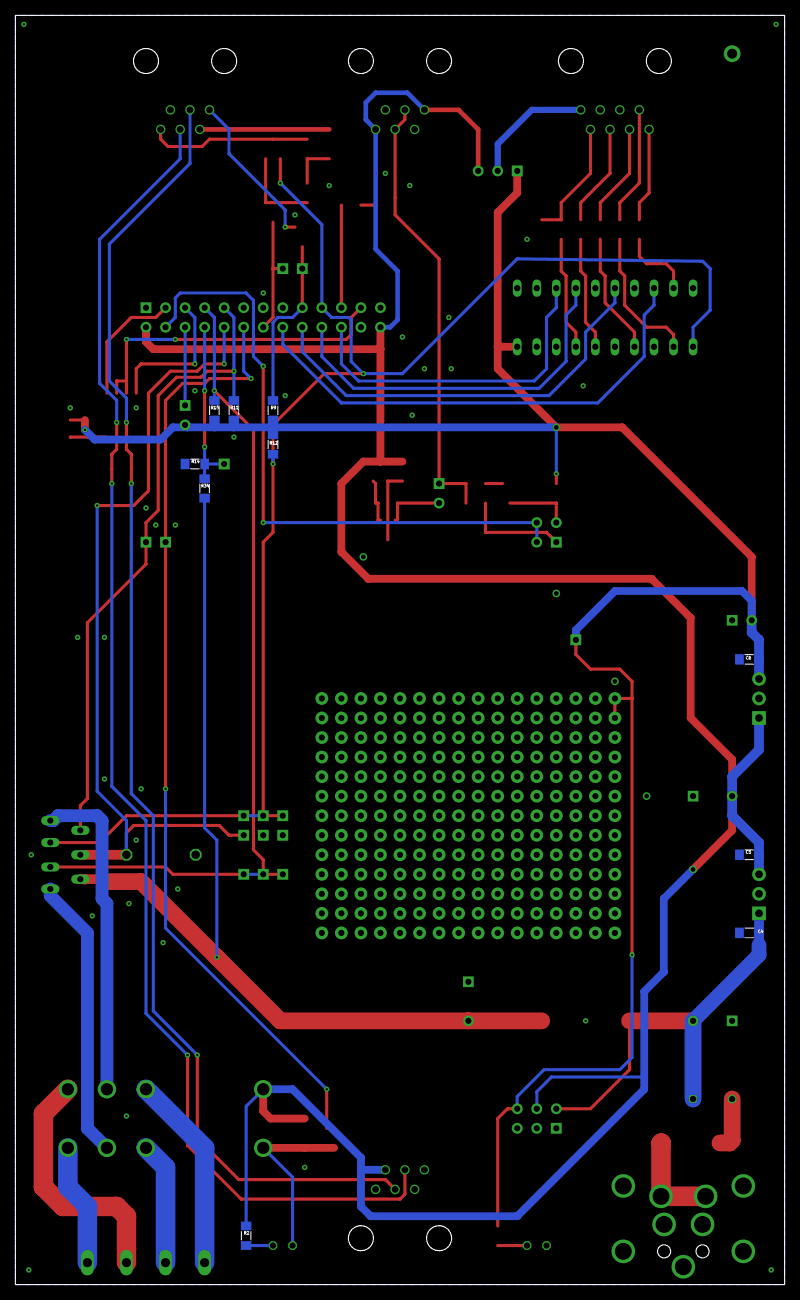
[picture p36: board Z21 MEGA_2.brd from below]

Board: 2 copper layers, 100.0 x 165.0 mm, 86 parts (10 on the bottom side), 61 nets.
